Marios-Dimopoulos/stm32-freertos-iot-gateway/docs/architecture.md

# Architecture

This document reflects the **actual current state** of the system, not the
target design. It is updated as subsystems are completed.

**Contents:**
[Current status](#current-status) ·
[Firmware](#firmware-phases-1-and-2) ·
[Architecture decisions](#architecture-decisions-so-far) ·
[System design](#system-design-implemented-this-is-what-runs) ·
[Verification status](#verification-status) ·
[Open questions](#open-questions-not-yet-decided) ·
[Where to continue](#where-to-continue) ·
[Gateway image and Phase 4](#gateway-image-phase-3-built-booted-reachable-over-wi-fi-and-ssh) ·
[Bring-up log (history)](#bring-up-log-history) ·

## Current status

Phases 1 and 2 (firmware) are finished and verified; Phase 3 has a minimal image of my own (`gateway-image`, 39 MB root filesystem, 82 packages) that boots, joins Wi-Fi by itself, can be reached over SSH and reads valid frames from the STM32 over SPI with a test tool; the kernel driver of Phase 4 is finished: my kernel module is an SPI driver that the kernel attaches to the STM32 node through a device-tree overlay (its `probe` runs at boot); a read of `/dev/stm32_sensor_node` does a throw-away transfer and then a second one after a minimum gap of 200 us, checks the marker and CRC and returns the 14 raw bytes of a fresh frame. MQTT is done and runs on the board: the Mosquitto broker listens on the gateway's loopback address only, and my C program `gateway-publisher` reads `/dev/stm32_sensor_node` and publishes one JSON message per frame to `gateway/stm32/bmp280`; init starts it at boot, after the broker. **Not done:** the open items under "Verification status".

FreeRTOS runs on the Nucleo at **84 MHz** (HSI + PLL) with three tasks. The
**sensor task** reads the BMP280 over I2C1 once a second, prints
`T=24.08 C  P=1017.61 hPa` over USART2 (115200 baud, ST-LINK virtual COM port,
Tera Term; a screenshot is in `docs/captures/phase1-terminal-output.png`), and
builds one 14-byte **frame** per period (marker, status, sequence, temperature,
pressure, CRC-16) that it keeps in a one-slot "latest frame" queue. SPI1 is a
**slave**; the master is a Raspberry Pi Zero 2 W. In Phase 2 it ran the stock Raspberry Pi OS
Lite with Python `spidev` as a **temporary test jig** (every Phase 2 number below comes from
it); since Phase 3 it runs my own image `gateway-image`, and since Phase 4 the master side is
my kernel driver (see "Phase 4: the kernel driver"). The **transmit task** (priority 2) is woken by an interrupt on the rising
edge of NSS (the end of a transaction) and loads the newest frame for the next
one; DMA2 stream 3 moves its bytes into the SPI data register, with no CPU
instruction in the transfer. All the reasoning, the failures found on the board
and the numbers are in **ADR-0010**.

**Verified and not verified:** see [Verification status](#verification-status).

**What exists:** the Keil project (`firmware/stm32-sensor-node/`) with the
FreeRTOS kernel and twelve application modules (clock, uart, i2c, bmp280, format,
frame, spi, sensor task, transmit task, hardfault, freertos_callbacks, main), twenty-two ADRs (`docs/decisions/`), the
test script `tools/spi_frame_test.py`, the README, this document, and the logic analyzer
captures of the I2C and SPI links (`docs/captures/`). On the gateway side, `linux-gateway/` has
the Yocto configuration and my layer `meta-gateway` (image recipe `gateway-image`, the kernel
module `stm32-node`, the device-tree overlay, the `spi-frame-test` tool, the Mosquitto broker
configuration, the `gateway-publisher` program and the Wi-Fi, SSH and boot-config changes). The image
boots, joins Wi-Fi, accepts SSH with a key, `/dev/stm32_sensor_node` returns a checked, fresh 14-byte
frame, and `gateway-publisher` publishes it to the local broker at boot.
**What does not exist:** a UART capture, a measured re-arm time, a logic analyzer capture of the kernel
driver.

**Where to continue:** see "Where to continue" below.

## Firmware (Phases 1 and 2)

The Keil project in `firmware/stm32-sensor-node/`: the toolchain, the FreeRTOS kernel and its
configuration, the application modules, the drivers, and the known gaps.

### Toolchain / project setup (done)

- Keil MDK-ARM project: `firmware/stm32-sensor-node/stm32-sensor-node.uvprojx`.
- Compiler: **Arm Compiler 6** (armclang V6.24).
- Single-precision FPU enabled in Target options (required by the
  `ARM_CM4F` port).
- Device support from the Keil STM32F4 DFP: `startup_stm32f411xe.s`,
  `system_stm32f4xx.c` (under `RTE/Device/STM32F411RETx/`).

### FreeRTOS kernel (V11.3.1): source integrated, configuration complete

```
firmware/stm32-sensor-node/FreeRTOS/
  event_groups.c list.c queue.c tasks.c timers.c   → group "FreeRTOS Core"
  include/                                          (vendor headers, unmodified)
  portable/GCC/ARM_CM4F/port.c, portmacro.h        → group "FreeRTOS Portable"
  config/FreeRTOSConfig.h                           → group "FreeRTOS Config"
```

- Include paths: `.\FreeRTOS\include`, `.\FreeRTOS\portable\GCC\ARM_CM4F`,
  `.\FreeRTOS\config`, `.\Src`.
- **Port:** `GCC/ARM_CM4F`, not `RVDS/ARM_CM4F`. The RVDS port uses armcc
  embedded assembler, which Arm Compiler 6 doesn't support. See ADR-0002.
- **No `heap_x.c`** is compiled on purpose, so `pvPortMalloc()` does not exist.
- Vendor files (`include/`, `portable/`, core `.c` files) are kept
  unmodified. Project-specific configuration lives only in `config/`.

### `FreeRTOSConfig.h`: all sections complete

| Section | Status | Settings |
|---|---|---|
| Memory allocation model | done | `configSUPPORT_STATIC_ALLOCATION 1`, `configKERNEL_PROVIDED_STATIC_MEMORY 0`, `configSUPPORT_DYNAMIC_ALLOCATION 0`, `configTOTAL_HEAP_SIZE 0` (ADR-0001) |
| Clock / tick | done | `configCPU_CLOCK_HZ (SystemCoreClock)`, `configTICK_RATE_HZ 1000`, `configUSE_PREEMPTION 1`, `configUSE_TIME_SLICING 1`, 32-bit tick (ADR-0003) |
| Tasks / stacks | done | `configMAX_PRIORITIES 3` (see task table below), `configMINIMAL_STACK_SIZE 128` words, idle/tick hooks off, `configUSE_TIMERS 0`, CLZ task selection, stack overflow check method 2, high-water mark enabled |
| Interrupt priorities (NVIC/BASEPRI) | done | `configMAX_SYSCALL_INTERRUPT_PRIORITY` = level 5 (raw `0x50`), via `configPRIO_BITS 4` + `configLIBRARY_MAX_SYSCALL_INTERRUPT_PRIORITY 5` |
| `configASSERT` | done | disable interrupts (BASEPRI) + infinite loop; enables the port's priority and handler-installation checks |
| Port handler mapping (SVC/PendSV/SysTick → startup file names) | done | direct routing: `#define vPortSVCHandler SVC_Handler` etc. |
| Optional API functions | done | `INCLUDE_vTaskDelay 1`, `INCLUDE_xTaskDelayUntil 1`, `INCLUDE_xTaskGetSchedulerState 1` (the I2C driver asserts with it) and `INCLUDE_uxTaskGetStackHighWaterMark 1` (set in the tasks section); the others stay at the default 0 |

### Application code (`firmware/stm32-sensor-node/Src/`)

- `main.c`: start-up only, in a fixed order: `clock_init_84mhz()`,
  `SystemCoreClockUpdate()`, `uart_init()`, `i2c_init()`, `spi_init()`,
  `sensor_task_create()`, `transmit_task_create()`, `spi_start()`,
  `vTaskStartScheduler()` (ADR-0003). The transmit task must exist before
  `spi_start()`, which enables the interrupt that notifies it. At the scheduler start
  the transmit task (priority 2) runs first and blocks at once, then the sensor task
  runs. The temporary blink task and the LED code are gone (PA5 is SPI1_SCK); they
  are in the git history.
- `sensor_task.c` / `sensor_task.h`: the sensor task, which owns the BMP280 and
  the I2C bus (priority 1, static 256-word stack + TCB, `vTaskDelayUntil` with a
  1 s period). Each period: if the sensor is not initialised it calls
  `bmp280_init()`; otherwise `bmp280_read()` and prints the line. **Any failure**
  is counted, printed as `BMP280 error: <cause> (failures: n)`, and the next
  period initialises the sensor again, so a sensor that was power-cycled
  recovers without resetting the MCU. Every line is built in a 64-byte buffer
  (sized for the worst case) and sent with one `uart_write()`. **Every period, in
  every case**, it also builds one frame (status `NO_READING` after a successful
  init, `OK` with the reading, or the matching failure cause with zeros; a private
  `switch` translates `bmp280_status_t` into `frame_status_t`), numbers it (the
  counter goes up before the build, so the first frame is 1 and 0 is kept for the
  placeholder), and hands it to a one-slot queue (`xLatestFrame`, private to the
  file, `xQueueOverwrite`). The sequence therefore keeps moving while the sensor
  fails: it is a heartbeat. `sensor_task_latest_frame()` copies the newest frame
  out with `xQueuePeek` and never waits. The stack was measured at 89 words peak in
  Phase 1 and again with the frame code at 96 words (160 free), and kept at 256
  (ADR-0005).
- `format.c` / `format.h`: three tiny text functions with no `printf` and no
  `malloc`: `format_text`, `format_u32` and `format_fixed2` (a number in
  hundredths with two decimals: 2364 gives `23.64`, -5 gives `-0.05`). They write
  into the caller's buffer and return the length, or 0 with nothing written if the
  text does not fit. The algorithm was checked in Python on edge cases
  (including the smallest `int32_t`); the C was exercised on the board with real
  values only.
- `freertos_callbacks.c`: `vApplicationGetIdleTaskMemory()` (static Idle TCB +
  stack sized with `configMINIMAL_STACK_SIZE`) and
  `vApplicationStackOverflowHook()` (raise BASEPRI and loop forever).
- `hardfault.c`: the HardFault handler. The start-up file's weak handler is only a
  branch to itself; this one replaces it. A small naked function picks the stack
  that was in use (bit 2 of `EXC_RETURN`: MSP for start-up code and interrupts, PSP
  for a task) and passes its pointer to a C function, which copies the eight
  registers the CPU pushed (R0-R3, R12, LR, **PC**, xPSR), the stack pointer,
  `EXC_RETURN` and the fault status registers (`CFSR`, `HFSR`, `MMFAR`, `BFAR`) into
  a static record, `xFaultRecord`, and stops. The stacked PC is the address of the
  faulting instruction. BusFault, MemManage and UsageFault are not enabled, so they
  all arrive here; the kind is in `CFSR`. It cannot help if the stack pointer itself
  is bad. **Tested on the board** (2026-10-17) with a deliberate read of an unmapped
  address, removed afterwards: the record in the debugger was what the comment at the
  top of the file predicts. How to repeat the test is in that comment.
- `clock.c` / `clock.h`: `clock_init_84mhz()` takes the CPU from the 16 MHz HSI
  to 84 MHz through the PLL (ADR-0006). Five steps in order: flash wait
  states (2) + prefetch + caches, bus prescalers (AHB /1, **APB1 /2 = 42 MHz**,
  APB2 /1), PLL numbers (M 8, N 168, P /4, source HSI), PLL on + bounded wait
  for `PLLRDY`, switch + bounded wait for `SWS`. Returns a status code and
  never hangs; on failure the CPU stays on the HSI. PLL limits are checked
  with `_Static_assert`. `main()` calls it before `SystemCoreClockUpdate()`.
- `uart.c` / `uart.h`: my own register-level USART2 driver (TX only, PA2 =
  AF7). `uart_init()` enables the USART2 and GPIOA clocks, sets PA2 as a
  push-pull, no-pull, low-speed alternate function (stated explicitly even
  where it equals the reset value; AFR written before MODER, MODER last),
  configures 8N1 at 115200 with
  the divisor `BRR = round(PCLK1 / baud)` computed from the real clock
  registers (365 = 0x16D at 42 MHz; it would still be readable on the HSI),
  enables the transmitter, and sets the interrupt priority before enabling it.
  `uart_write()` copies a whole message into a 256-byte static ring buffer
  inside one FreeRTOS critical section and sets `TXEIE`; `USART2_IRQHandler`
  (level 10, i.e. at or below the FreeRTOS line, checked with
  `_Static_assert`) sends one byte per interrupt and clears `TXEIE` when the
  buffer is empty. Only the sensor task calls it today. The critical section
  protects the shared `CR1` register (a benign race, kept anyway) and, for any
  future second caller, task against task and the free-space check with the
  copy as one unit. **All or nothing:** if the message does not fit, nothing is
  stored and `UART_ERR_FULL` is returned, so a line is never cut and tasks'
  messages never interleave. There is no drop counter (removed 2026-10-16: a
  drop cannot happen with one short line per second). Never waits. Tasks
  only, after the scheduler has started (asserted at the start of `uart_write()`,
  like the I2C driver's calls).
  Verified in Tera Term, including the drop behaviour with a temporary burst
  test (removed): two 102-byte lines arrived complete and the third was
  dropped whole.
- `i2c.c` / `i2c.h`: my own register-level I2C1 master driver for the BMP280
  (PB8 = SCL, PB9 = SDA, AF4). `i2c_init()` enables the GPIOB and I2C1 clocks,
  resets I2C1 (`SWRST`), sets the pins as open-drain alternate function with
  the internal pull-up as a backup (MODER written last), programs the 100 kHz
  timing (`CR2.FREQ` = 42, `CCR` = 210, `TRISE` = 43, computed from the real
  APB1 clock) and enables the peripheral. `i2c_write_reg()` and
  `i2c_read_reg()` (1 byte, or 3 or more; 2 is refused because nothing needs
  it) do a whole register transaction and return `I2C_OK`, `I2C_ERR_NACK`,
  `I2C_ERR_TIMEOUT` or `I2C_ERR_BUS`. The waits are bounded in real time by the
  RTOS tick (about 10 ms each), so the driver is task-only; the receive
  deadline operations (clear ACK, ADDR, STOP) run in a short critical section.
  After a timeout, a bus error or a bus that stays busy the driver pulses
  `SWRST` and re-initialises I2C1 itself (counted by `i2c_recovery_count()`,
  which nothing reads); the public functions assert that the scheduler has
  started. **Verified on the board with the BMP280 at 0x76:** register write,
  chip ID 0x58, the 6-byte burst and the 24 trimming bytes; a missing sensor
  gives NACK without hanging; the sensor-disconnect test recovers by itself.
  Grounding SDA gave TIMEOUT on 2026-10-06 and NACK on 2026-10-08 (not
  investigated). **Limits:** no bus clear (a sensor holding SDA low is not
  freed); the pull-ups of the breakout were never measured. **Seen on the wire
  (2026-10-20):** the 3-or-more-byte receive sequence gives ACK on every byte but the
  last and NACK on the last, and SCL runs at a typical 101.1 kHz for the 100 kHz set.
  A sensor locked out by CSB needs a power cycle, which no I2C
  driver can fix (see the BMP280 entry). Decisions (register API, 7-bit
  address, distinct error codes, tick-based bounded polling, critical section
  for the time-critical receive operations, single owner without mutex,
  self-recovery, 100 kHz): ADR-0007.
- `bmp280.c` / `bmp280.h`: the BMP280 module, on top of `i2c_read_reg()` /
  `i2c_write_reg()`; one task owns it (no mutex). `bmp280_init()` does, in
  order: the soft reset (0xB6 to 0xE0), a 10 ms `vTaskDelay`, the chip-ID check
  (0xD0, expected 0x58), a read of the 24 factory trimming bytes into a local
  buffer and, only if it worked, their unpacking (low byte first; `dig_T1` and
  `dig_P1` unsigned, the other ten signed) into a static struct, and then the
  two configuration registers: `config` (0xF5: standby 0.5 ms, IIR filter 16)
  before `ctrl_meas` (0xF4: x16 oversampling for both, normal mode), built from
  named fields (0x10 and 0xB7). Writing `ctrl_meas` starts the measurements.
  The registers are not read back: a wrong value would show in the
  measurements. It must run in a task, after the scheduler has started, and a
  flag set only after a complete init lets `bmp280_read()` assert that init
  succeeded. `bmp280_read()` does one 6-byte burst from 0xF7, assembles the
  two 20-bit raw values (0x80000 means no measurement yet:
  `BMP280_ERR_NO_DATA`) and applies Bosch's integer compensation as two pure
  functions (temperature in 32 bits, pressure in 64 bits; left shifts of
  possibly negative terms are written as multiplications). It returns a
  `bmp280_reading_t`: temperature in hundredths of a degree, pressure in Pa.
  Status codes: `BMP280_OK`, the I2C cause (NACK, TIMEOUT, BUS), `ERR_ID`, and
  `ERR_NO_DATA` (also used if the pressure divisor would be zero);
  `bmp280_status_text()` gives the text. **Verified on the board:** OK with the
  sensor connected; NACK with CSB at GND after a power cycle; the trimming
  bytes in the typical ranges; a reading of 2364 (23.64 C) and 101969 Pa in the
  debugger, now printed every second, stable. With the sensor powered, a
  falling edge on CSB makes it answer NACK until its power is cycled, even
  after CSB goes back to 3.3 V (reproduced twice): CSB must be wired firmly to
  3.3 V. The register layouts and codes were compared with the BMP280 datasheet
  (2026-10-20) and match; the filter code is the one item its text does not list.
  Decisions: ADR-0009.
- `frame.c` / `frame.h`: the contract with the Pi. `frame_build()` writes a 14-byte
  frame byte by byte (little-endian, no struct): marker `0xA5`; status
  (`frame_status_t`: `OK`, `NO_READING`, `SENSOR_NACK`, `SENSOR_TIMEOUT`,
  `SENSOR_BUS`, `SENSOR_ID`, `SENSOR_NO_DATA`, with fixed numbers because they go
  on the wire); sequence (`uint16`); temperature (`int32`, hundredths of a degree);
  pressure (`uint32`, pascals); CRC-16/CCITT-FALSE (polynomial `0x1021`, start
  value `0xFFFF`) over the first 12 bytes, low byte first. A pure function with no
  state. The bytes the C code produces match a Python replica, in the debugger and
  over the wire (test vectors in ADR-0010).
- `spi.c` / `spi.h`: SPI1 as a **slave** (mode 0, 8-bit, MSB first, hardware NSS;
  PA4 NSS with pull-up, PA5 SCK with pull-down, PA6 MISO push-pull, PA7 MOSI; all
  AF5). `spi_init()` enables the clocks, sets the pins and configures SPI1, and
  leaves it **disabled**. `spi_start()` configures DMA2 stream 3 once (channel 3 =
  SPI1_TX, normal mode, memory increment; `PAR` = `SPI1->DR`, `M0AR` = the buffer,
  both base addresses written once), loads a placeholder frame, enables the NSS
  interrupt and only then enables the SPI. `spi_load_frame()`, called by the
  transmit task, stops the stream with a bounded wait, copies the frame into the
  DMA buffer (`ucDmaFrame`, written nowhere else), **writes byte 0 into `DR`
  itself**, sets `NDTR` for the remaining 13 bytes and enables the stream: the
  state after it is the same whatever the previous transaction was. The EXTI line 4
  handler (NVIC level 6) clears the pending bit and reads PA4: high means a real
  end of a transaction (counted in `ulNssRisingCount`, the transmit task is woken),
  low means a spike (counted in `ulNssGlitchCount`, nothing else). Counters for the
  debugger: `ulNssRisingCount`, `ulNssGlitchCount`, `ulReloadFailures`. Decisions
  and failures: ADR-0010.
- `transmit_task.c` / `transmit_task.h`: priority 2, static 128-word stack (measured:
  39 words peak, ADR-0005). It waits without limit for a task notification (`ulTaskNotifyTake( pdTRUE,
  portMAX_DELAY )`: the count is cleared, so ends that merge cost one wake-up), then
  fetches the newest frame with `sensor_task_latest_frame()` (the placeholder if the
  queue is still empty) and calls `spi_load_frame()`. `ulWakeUps` counts its
  wake-ups. The NSS handler gives it the notification through
  `transmit_task_end_of_transaction_from_isr()`; the handle stays private.
- Footprint, from the Keil build of 2026-10-17 10:52
  (`Listings/stm32-sensor-node.map`): Code 18,316 B, RO data 612 B (18,928 B = 18.5 KB
  of flash in total), RAM 4,072 B of 128 KB (RW 8 B + ZI 4,064 B, including the 1 KB
  main stack, the stacks of the sensor task (1 KB) and the transmit task (512 B), the
  UART buffer, and the 56-byte fault record). The start-up heap is 0 bytes since
  2026-10-17: the 512-byte C-library heap that nothing used is gone (RAM was 4,536 B
  in the map of 2026-10-15, before it and before the record were added). The growth
  since Phase 1 (12.8 KB of flash, 3.8 KB of RAM) is the frame, SPI, DMA, EXTI,
  transmit-task and fault-handler code, plus the queue code of the kernel. **No
  `malloc` is linked** (the only matches in the map are the library function
  `_get_argv_nomalloc`). The 64-bit division comes from the C library
  (`__aeabi_ldivmod`). Keil's static stack report gave 324 B for the start-up call
  chain on the main stack in an earlier build (interrupts not included).

### Drivers

The course/teacher drivers (ARM University Program, ST Standard Peripheral
Library, teacher-written I2C) are kept **locally only** in
`firmware/**/reference/` (git-ignored, outside the Keil project) as reading
material. The clock, USART2, I2C1 and SPI1/DMA drivers were written from scratch at
register level, and the BMP280 module is built on them (the compensation
formulas are Bosch's, as in the `functions.c`). The decision to write own
register-level drivers instead of using a vendor library is ADR-0008.

### Known gaps (real current state, not bugs)

- **What the logic analyzer showed on 2026-10-20, and what is still open** (the re-arm time,
  the UART bit time): see "Verification status" (ADR-0006, ADR-0007, ADR-0010).
- **Spikes on NSS** (ADR-0010, decision 8): the counts, what the handler does and the open cause
  are in "Verification status".
- **The first read after an idle time is stale.** The buffer is refilled right
  after each transaction and nothing refreshes it, so a Pi that has not read for a
  minute gets a frame about a minute old (the sequence number shows it). The node is
  unchanged; the Phase 4 driver reads twice and keeps the second frame (ADR-0019), so
  programs that use `/dev/stm32_sensor_node` get a fresh one. A node that has just
  started can still return the placeholder (`status=1`) for its first second.
- The Phase 2 numbers come from the stock Raspberry Pi OS with Python `spidev`, a
  temporary jig (ADR-0010). The final master is `gateway-image` with the kernel driver.
- The SPI `OVR` flag (received bytes are never read) is set and not cleared;
  nothing has gone wrong that it would explain (30000 back-to-back reads were good).
- **Stacks.** Measured on 2026-10-18 after 60 reads from the Pi, as lower bounds:
  sensor task 96 words peak of 256, transmit task 39 words of 128 (the placeholder
  path did not run, and the NACK paths were not exercised). Idle: at least 21 words
  actually written (the `0xA5` pattern said 14, but R4-R11 were saved with the fill
  value, so the pattern was forged by data), 128 words allocated (ADR-0005).
- **Clock accuracy is that of the HSI: measured about 1.1% fast (ADR-0006).** The
  timeout/error paths of
  `clock_init_84mhz()` have never been triggered. `SystemCoreClock` reports HCLK
  only: USART2 and I2C1 must use the 42 MHz APB1 clock.
- `vApplicationGetTimerTaskMemory()` is NOT needed (`configUSE_TIMERS 0`).
- The I2C driver has no bus clear (a sensor holding SDA low is not freed), and
  nothing reads `i2c_recovery_count()`.
- The BMP280 can be locked out of I2C by a glitch on CSB until its power is
  cycled; the sensor task reports it and keeps trying, but only a power cycle
  fixes it.
- `docs/captures/` holds the Phase 1 screenshot and the logic analyzer captures (its
  README lists them). `docs/budget.md` is not updated with the real purchases.
- There is no LICENSE file (a decision, not an oversight).

## Architecture decisions so far

- ADR-0001: static-only memory allocation for FreeRTOS objects.
- ADR-0002: GCC/ARM_CM4F FreeRTOS port with Arm Compiler 6.
- ADR-0003: RTOS tick derived from `SystemCoreClock`, at 1 kHz.
- ADR-0004: interrupt priority threshold for FreeRTOS API calls at level 5.
- ADR-0005: task stacks sized by measurement with a margin; Idle stays at 128
  words; the sensor task (96 words peak) and the transmit task (39 words peak) were
  measured and keep 256 and 128.
- ADR-0006: CPU at 84 MHz from the HSI through the PLL, in its own module.
- ADR-0007: I2C1 driver: register-oriented polling API with tick-based timeouts and
  self-recovery.
- ADR-0008: own register-level drivers instead of a vendor library (decided
  2026-10-02, recorded 2026-10-08).
- ADR-0009: BMP280 module: normal mode, integer results, initialise again after
  every error.
- ADR-0010: the SPI link: the Pi as master and the STM32 as slave, a fixed 14-byte
  frame with CRC-16, a one-slot latest-frame queue, a transmit task that re-arms a
  normal-mode DMA on the NSS rising edge; the CPU primes the data register
  (decision 7); NSS spikes are ignored (decision 8).
- ADR-0011: the gateway image is built with Yocto (not Buildroot): the industry standard,
  and its layers keep my driver and recipes separate from the Raspberry Pi support.
  Phase 3 has started.
- ADR-0012: Yocto Wrynose 6.0 (LTS); BitBake 2.18, openembedded-core, meta-yocto and
  meta-raspberrypi cloned by hand into `~/yocto/` in WSL, outside the repo.
- ADR-0013: the `synaptics-killswitch` license flag is accepted so that the Pi Zero 2 W's
  Wi-Fi firmware is built into the image (the gateway needs Wi-Fi).
- ADR-0014: the `buildpaths` quality check is switched off for the `perl` recipe only
  (a workaround; the cause is not found; perl is not in the image).
- ADR-0015: the Wi-Fi network is typed on the board for now (the password stays out of the
  repo and the build) and OpenSSH is the SSH server; it also records the first OpenSSH build
  that shipped seven 0-byte programs.
- ADR-0016: a layer of my own, `meta-gateway`, with a `.bbappend` that replaces
  `/etc/network/interfaces` (`auto wlan0`, `nl80211`), so Wi-Fi starts at boot.
- ADR-0017: an image recipe of my own, `gateway-image`, built up from `packagegroup-core-boot`
  one tested step at a time (142 MB and 2015 packages down to 37 MB and 76).
- ADR-0018: a kernel SPI driver (not `spidev`) with a character device that returns the raw 14-byte
  frame; the driver checks the marker and CRC, the reading program decodes the values; `probe` does
  not fail when the node does not answer.
- ADR-0019: the stale first read is handled in the driver: every `read()` does a throw-away transfer
  first and returns the second frame (no firmware change; about 0.4 ms more per read).
- ADR-0020: the MQTT broker (Mosquitto) runs on the Pi and the publisher is a C program with
  libmosquitto; both come from `meta-openembedded`, a fifth repository. Built and running.
- ADR-0021: one JSON message per frame on the topic `gateway/stm32/bmp280`; the publisher reads every
  0.2 s and publishes when `seq` changes; a frame with `status` other than 0 is published without
  numbers, and `-EIO` is only logged; the broker listens on localhost only, reached through an SSH tunnel.
- ADR-0022: the publisher is started at boot by an init script (`S40`, after the broker's `S30`), waits
  by itself for the device file and the broker, and logs to syslog (`/var/log/messages`).

## System design (implemented: this is what runs)

```
 BMP280 ──I2C1 (PB8 SCL, PB9 SDA)──┐
                                    ▼
        ┌─────────────────────────────────────────────────────────────┐
        │ STM32F411RE (Nucleo, 84 MHz), FreeRTOS, static allocation   │
        │                                                             │
        │  Sensor task (prio 1, 1 s) ──frame──► latest-frame queue    │
        │       │                                    │ xQueuePeek     │
        │       └─ lines ─► USART2 (PA2) ─► ST-LINK  │                │
        │                   virtual COM, Tera Term   ▼                │
        │  Transmit task (prio 2) ◄─ notify ◄─ EXTI4 ISR (NSS rising) │
        │       │ spi_load_frame()                                    │
        │       ▼                                                     │
        │  ucDmaFrame ──DMA2 stream 3──► SPI1->DR  (SPI1 slave)       │
        └───────────────────────────────────────────┬─────────────────┘
                              PA4 NSS, PA5 SCK, PA6 MISO, PA7 MOSI │
                                                                    ▼
                                       Raspberry Pi Zero 2 W (SPI master)
```

The gateway side (Phase 3 and 4, implemented up to the MQTT broker):

```
 STM32 node ──SPI0, chip select 0, 1 MHz──► spi-bcm2835 (controller driver)
                                                   │
                  SPI core (spi.c): spi_sync_transfer, queue
                                                   │
        stm32_node.ko (my spi_driver, bound by the overlay's compatible)
          read(): transfer, wait 200 us, transfer, check marker + CRC
                                                   │
                           /dev/stm32_sensor_node  (14 raw bytes per read)
                                                   │
                  gateway-publisher (C, libmosquitto): read every 200 ms,
                  publish JSON when seq changes
                                                   │ localhost:1883 (loopback only)
                  Mosquitto broker ── topic gateway/stm32/bmp280
                                                   │ SSH tunnel (tested 2026-11-01)
                  subscribers: mosquitto_sub on the Pi; my laptop
```

- One task reads the BMP280 over I2C1 (PB8/PB9) once a second and builds a frame.
- **Sensor: Bosch BMP280** (temperature + pressure; no humidity, unlike the
  BME280). Chip ID register `0xD0` reads `0x58`. I2C address `0x76` or
  `0x77` depending on the SDO pin.
- **Debug logging:** the sensor task prints readings directly over USART2
  (PA2 = TX; PA3 = RX is not used), which the Nucleo's ST-LINK exposes as a
  virtual COM port, by interrupt through a ring buffer, whole messages or
  nothing. This is a debug-only aid, not part of the data path (that is SPI +
  DMA). No dedicated logging task.
- No MPU-6050 IMU: it was dropped from the design.
- All RTOS objects (the tasks, the latest-frame queue) are statically allocated.

### The frame (the contract with the Pi, `frame.h`, ADR-0010)

| Bytes | Field |
|---|---|
| 0 | marker `0xA5` |
| 1 | status (`frame_status_t`: 0 OK, 1 no reading yet, 2 to 6 the sensor failure causes) |
| 2-3 | sequence (`uint16`, +1 per frame built, the first is 1; 0 is the placeholder) |
| 4-7 | temperature (`int32`, hundredths of a degree Celsius) |
| 8-11 | pressure (`uint32`, pascals) |
| 12-13 | CRC-16/CCITT-FALSE over bytes 0 to 11, low byte first |

All multi-byte fields are little-endian. The Pi decides when to read (it polls); the
node always keeps the newest frame loaded. A dead node reads as `0xFF` or `0x00`,
never `0xA5`; a repeated sequence means "nothing new"; a jump means frames were
skipped; a wrong CRC means damage.

### Task set and priorities (implemented)

Task priority: higher number = more urgent. `configMAX_PRIORITIES = 3`.

| Priority | Task | Why this level |
|---|---|---|
| 2 | Transmit task (re-arms the SPI DMA after every transaction) | The Pi is the SPI master and clocks data out when it decides, so the deadline is imposed from outside; when the interrupt wakes it, it must run at once, even in the middle of an I2C transfer of the sensor task. |
| 1 | Sensor task (BMP280 over I2C1, frames, debug prints) | Period chosen by me; a few ms of lateness is harmless. |
| 0 | Idle | Runs when nothing else is ready. |

At start-up the transmit task runs first (it is the highest priority), blocks at once,
and the sensor task runs next.

### Interrupt levels (lower number = more urgent)

ISRs that call `...FromISR()` functions must be at level 5 or a larger number
(ADR-0004).

| Level | Interrupt | Note |
|---|---|---|
| 6 | EXTI line 4 (NSS rising edge) | calls `vTaskNotifyGiveFromISR`; more urgent than the UART because the re-arm must finish before the next chip select |
| 10 | USART2 (transmit) | calls no FreeRTOS function |
| 15 | PendSV, SysTick | set by the kernel port |

No DMA interrupt is used: the stream stops by itself after its count, and the end of a
transaction is detected on the NSS pin (ADR-0010, decision 6).

## Verification status

What was measured on the board, what was not, and what is still undecided, in one place. The tests of
Phases 3 and 4 are under their own steps in the Gateway image section (Wi-Fi and SSH, SPI and the
test tool, steps 4.2 to 4.6c, "Checks on the board").

### Verified on the board (Phases 1 and 2)

- Phase 1: register values and SysTick `LOAD = 83999` checked in the debugger;
  disconnecting the BMP280 gives `NACK` and everything comes back by itself; a
  falling edge on its CSB pin locks it out of I2C until its power is cycled
  (ADR-0007).
- The Pi reads a real frame every second with a valid CRC, at SPI clocks from
  100 kHz to 6 MHz, and back to back from Python (no pause between reads).
- 3000 reads in about 35 s with the node running freely: every interrupt and
  wake-up counted, no I2C error on the sensor task (the transmit task preempts it).
- A short or interrupted transaction does not leave the node shifted by one byte:
  at every re-arm the CPU writes byte 0 into the SPI data register itself
  (ADR-0010, decision 7).
- A 30-minute run (1800 reads, 1 s apart): 1797 good, 0 shifted, 3 bad. The node's
  counters agreed with the Pi (1800 ends, 1800 wake-ups, 0 reload failures), and 15
  spikes on NSS were ignored. One of the bad frames is a 2-bit slip, probably noise
  on SCK (ADR-0010).
- Ten runs of the test script stopped with Ctrl+C, and a run after them: no shifted
  or bad frame (ADR-0010).
- Noise on NSS: spikes on that line are ignored by the interrupt handler
  (decision 8). With the wires still, 7 spikes were seen in 3000 transactions and
  none damaged a frame; moving the wires by hand corrupts frames, which the Pi
  detects with the CRC, and the next frame is good.
- The sensor failing travels in the frame: with SDA unplugged the Pi gets frames
  with status `NACK` and zeros, then `NO_READING`, then `OK` when it is back.
- On the wire, with a logic analyzer (2026-10-20, `docs/captures/`): every BMP280 read
  is START, `0xEC`, `0xF7`, repeated START, `0xED`, six bytes (ACK on the first five,
  NACK on the last), STOP, 834 us (ADR-0007); the SPI frame is 112 clocks in mode 0 and
  decodes with a valid CRC; SCK measured 1.000, 2.000, 3.997 and 5.88 MHz for 1, 2, 4
  and 6 MHz requested; NSS stays high 154 to 228 us between back-to-back reads, and
  30000 such reads were good (ADR-0010). The CPU clock runs about 1.1% fast (ADR-0006).
- More from the same captures (logic analyzer: a Raspberry Pi Pico with sigrok-pico): the
  clock error above makes the "1 s" sensor period 0.988 to 0.989 s; for 1 MHz requested
  SCK was once 0.625 MHz (ADR-0010); the Pi adds one extra clock period between bytes; the 30 gaps
  between back-to-back Python reads were 154 to 228 us, and 30000 such reads were all good.

### Not verified

- **The re-arm time of the node** is not measured, only an upper bound: the node was ready within
  the 154 us minimum gap of back-to-back reads (the measurements are listed above). Measuring it
  would need a marker pin in the firmware. A kernel driver or a C program may be
  much faster than Python, so the Phase 4 driver enforces a 200 us delay (step 4.5b, not yet seen on
  the wire); whether 200 us is a real margin needs a logic analyzer capture of NSS with the kernel
  driver.
- **The UART bit time** is not measured: PA2 is wired to the ST-LINK only. With the solder bridges at
  their default, SB62 and SB63 open, the `D1` socket and the morpho pin do not carry it, per the
  Nucleo-64 manual UM1724 (PA2 is not reachable on the headers). I did not change the bridges, so the
  board was not modified.
- **The cause of the NSS spikes** that the firmware counts is not settled. They are 0.2% to 0.8% of
  the transactions with the wires still (the counts are listed above), many when the wires are moved;
  the interrupt handler ignores them (ADR-0010, decision 8). The logic
  analyzer saw spikes of 50 ns on NSS exactly at SCK's falling edge with a probe wiring that disturbed
  the link (spikes only with such a wiring), and none in about 40 frames with a clean wiring; long
  jumpers are the suspect. Frames hit by a real loss of contact are corrupted, and the CRC finds them;
  the next one is good.
- **MOSI on the wire** is not verified (`docs/captures/README.md` says why it was not probed).
- **The stale first read after an idle time** still exists in the node; the Phase 4 driver hides it
  (ADR-0019; the mechanism is under "Known gaps").
- I did not compare the SSH host key fingerprint on the board with the one the client
  showed, and I did not log in with the name `raspberrypi0-2w-64.local` (the error type
  suggests it resolved).
- The cause of the 0-byte OpenSSH programs is a hypothesis; I also cannot explain why
  `test -x /usr/sbin/sshd` was false on the board for an empty file with the executable bit.
  After every build I should look for zero-byte files in the root filesystem folder.
- The root filesystem on the board is writable, and `/boot` (FAT) is mounted read-write with
  `defaults`: a power cut during a write there could corrupt it. For the final image it should
  be read-only or not mounted (decided on 2026-10-27 not to do it in this project).
- The Wi-Fi key and the root password hash are inside every image and in the build folder.
  Anyone with the SD card can read them. SSH is key-only since 2026-10-27; the
  private key is on my PC without a passphrase, so whoever copies that file can log in.
- Phase 4 driver, not verified: the 200 us gap and the 1 MHz clock on the wire (no logic analyzer
  capture of the driver; the exact clock the divider gives), 500 sequential reads with the 4.5c
  build, and why the first module build recompiled the whole kernel.
- Only the driver's `-EIO` path (node off) and `-EINVAL` (`bs=4`) were seen; `-EFAULT` and
  `-ENODEV` were not triggered. The driver does not say whether the marker or the CRC failed.
- Wi-Fi power save: the commit `254c5d3` adds a line to `interfaces` that turns power save off after
  `ifup`, because I suspected it of unanswered ARP and dropped SSH. It is in the image since the
  build of 2026-10-31, and `iw dev wlan0 get power_save` says `Power save: off` on the board; at boot
  `dmesg` shows `power save disabled` (2026-11-01). That shows the setting is applied. It does not show
  that the original problem is gone; that needs time on the network, and I have not watched for it.
- The `spi-frame-test` runs (two, 10 frames each) were on the old image with `/dev/spidev0.0`; no speed
  sweep, no minimum-gap test, nothing on the logic analyzer from the gateway image.
- `perl` is built although it is not in the image; why is not known (ADR-0014).
- `core-image-base` carried things a headless sensor gateway does not need (the services
  `alsa-state`, `avahi-daemon`, `bluetooth`, `ofono`, `neard`); `gateway-image` does not. The
  boot partition still has an audio line in `config.txt` (`dtparam=audio=on`). The graphics
  overlay and the 256 MiB CMA pool are gone since 2026-10-27. Switching the
  graphics off with `DISABLE_VC4GRAPHICS = "1"` failed the build in `cairo` (the `meta-raspberrypi`
  `cairo_%.bbappend` adds an `egl` option that `cairo` 1.18.4 does not have), so I left it as it
  is (ADR-0017 update of 2026-10-25).
- `bblayers.conf` uses `${TOPDIR}/../` paths
  since 2026-11-01 (checked with `bitbake-layers show-layers` and `bitbake -p`), so it needs `build/`
  and the layers in the same parent folder. BitBake reads `~/yocto/meta-gateway`, not the copy in
  git; the two are kept the same by hand. Three files changed in git on 2026-11-02 and 2026-11-03:
  `gateway-image.bb` (the root password file is now found at `${TOPDIR}/../secrets/root.hash`),
  `stm32_node.c` (one comment) and the Wi-Fi `.bbappend` (the secrets folder is now
  `${TOPDIR}/../secrets` instead of an absolute path with my user name). On 2026-11-03 I copied all
  three to `~/yocto/meta-gateway` and built the image (`...rootfs-20261103174036.wic.bz2`). In the
  root filesystem folder the root field of `/etc/shadow` is the same as `root.hash`, and
  `/etc/wpa_supplicant.conf` is the same as my secrets file (not the placeholder). Both checks printed
  only SAME or DIFFERENT, never the values. I flashed this image the same day: the Pi joined Wi-Fi at
  boot with only power connected, SSH with the key worked, root logged in with the password on the
  serial console, and `mosquitto_sub` showed the messages again.
- **The shutdown order** on the board is not verified: the `rc6.d` links put `K20gateway-publisher`
  before `K20syslog` and `K30mosquitto` (see "How the driver is found and loaded" in the Phase 4
  section); a shutdown was not watched.
- **A frame with a bad CRC produced on purpose** was not seen: my test of shaking the wires, 1000
  reads with no failure, was too weak to show anything.

### Open questions (not yet decided)

- Whether the publisher needs to be restarted by init if it crashes (ADR-0022: nothing does it now).
- Whether the HSI accuracy stays good enough, or the clock moves to the ST-LINK's
  8 MHz HSE (needs `HSE_VALUE=8000000`, see ADR-0006). Measured: about 1.1% fast
  (ADR-0006), which nothing in the project needs better than so far; to be decided
  again if a precise timestamp or USB is ever needed, and checked against the UART
  bit time.
- Whether a bus clear is ever needed in the I2C driver (only if a sensor is
  seen holding SDA low).
- The spikes on NSS, the re-arm time and the 200 us gap are not decisions but missing
  measurements: see "Not verified" above.

## Where to continue

### Phases 1 and 2: finished

Phase 2 is closed. What was done: the long run and the aborted runs with
`tools/spi_frame_test.py` (ADR-0010), the stack measurements (ADR-0005), and the logic
analyzer captures of I2C and SPI (2026-10-20, `docs/captures/`). Open items that are accepted and not blocking: the re-arm time, the UART bit time, whether the
firmware's own NSS spikes are real, and the stale first read after an idle time (the Phase 4
driver handles it, ADR-0019). Details: "Verification status".

### Phases 3 and 4

Phase 3: the image is built, flashed and boots on the board to a root login on the serial
console (see "First boot" in the Bring-up log). Wi-Fi starts at boot (ADR-0016) and the network is in the
image (key kept outside the repo, ADR-0015), so SSH works after a flash with nothing typed.
SPI is on and the test tool `spi-frame-test` read valid frames from the STM32 (see "SPI and
the test tool"). The image is my own minimal recipe (ADR-0017). Root has a password (hash kept
outside the repo, ADR-0015 update of 2026-10-24) that only the serial console asks for: since
2026-10-27 SSH accepts a key only. The clean-up of the image is done as far as I decided
(ADR-0017 updates of 2026-10-25 and 2026-10-27).

Phase 4: the kernel driver is finished (see "Phase 4: the kernel driver"). The two requirements
that came from Phase 2 are met: a minimum delay between SPI transfers (step 4.5b) and a policy
for the stale first read (read twice, step 4.5c, ADR-0019). Step 4.6 (MQTT) is done since 2026-11-01 and step 4.7 (docs) since 2026-11-02.

## Gateway image (Phase 3: built, booted, reachable over Wi-Fi and SSH)

The image is built with Yocto Wrynose 6.0 (ADR-0011, ADR-0012) in WSL2 (Ubuntu 24.04,
12 GB of RAM given to WSL through `.wslconfig`). The repos are cloned by hand into
`~/yocto/`, outside this repo. Cloned on 2026-10-18:

| Repo | Branch | Commit | Date of the commit |
|---|---|---|---|
| `bitbake` | `2.18` | `6e260eb6ab16` | 2026-10-07 |
| `openembedded-core` | `wrynose` | `636e5d3b12d5` | 2026-10-12 |
| `meta-yocto` | `wrynose` | `7c25b1115655` | 2026-09-30 |
| `meta-raspberrypi` | `wrynose` | `919588393f41` | 2026-10-10 |
| `meta-openembedded` (added 2026-10-31, ADR-0020) | `wrynose` | `c734c2cb9713` | 2026-10-29 |

### Build configuration

The configuration is used from `~/yocto/build/conf/` in WSL. Copies are in
`linux-gateway/conf/`: `bblayers.conf` byte for byte, and `local.conf` trimmed to its
active lines with my comments (the 20 active lines were compared with the real file on
2026-10-25 and are identical; the `local.conf` check was not repeated on 2026-10-31).
`bblayers.conf` lists seven layers: `openembedded-core/meta`, `meta-yocto/meta-poky`,
`meta-raspberrypi`, `meta-gateway` (mine, ADR-0016; it is in `~/yocto/` and a copy is in
`linux-gateway/meta-gateway/`) and, since 2026-10-31, `meta-oe`, `meta-python` and `meta-networking`
from the one repo `meta-openembedded`. Mosquitto is in `meta-networking`, which depends on the other
two; `meta-python` makes recipes available but puts no Python in the image. Added with
`bitbake-layers add-layer`, which checked the dependencies; the repo copy was compared with the real
file (identical). `local.conf` adds, on top of the template:

```
MACHINE = "raspberrypi0-2w-64"
DISTRO = "poky"
ENABLE_UART = "1"
LICENSE_FLAGS_ACCEPTED = "synaptics-killswitch"       (ADR-0013)
INSANE_SKIP:perl += "buildpaths"                      (ADR-0014)
ENABLE_SPI_BUS = "1"                                  (added 2026-10-23: `dtparam=spi=on` in config.txt)
USE_VT = "0"                                          (added 2026-10-25: no getty on tty1)
```

The package list and the `IMAGE_FEATURES` (`ssh-server-openssh`; `allow-root-login` was removed on
2026-10-27) of the current image are not in `local.conf` but in my image recipe
`meta-gateway/recipes-core/images/gateway-image.bb` (ADR-0017), together with the functions that
write the root password hash and install the SSH public key. Until 2026-10-24 the `IMAGE_FEATURES`, including the two that
allowed an empty root password, were in `local.conf` and applied to every image.

### The image recipe `gateway-image` (2026-10-24, ADR-0017)

`meta-gateway/recipes-core/images/gateway-image.bb` inherits `core-image` for the image tasks, but
replaces its package list: `IMAGE_INSTALL = "packagegroup-core-boot"` plus Wi-Fi (`wpa-supplicant`,
`iw`, `wireless-regdb-static`, the firmware packages `...bcm43430` and `...bcm43436`, the modules
`brcmfmac`, `brcmfmac-cyw`, `brcmutil`, `cfg80211`), SPI (`spi-bcm2835`, `spidev`) and
`spi-frame-test`, and (since 2026-10-25) my kernel module `stm32-node`. Since the overlay of step 4.3,
`spidev@0` is disabled, so `spidev` and `spi-frame-test` are still in the image but cannot be used on
chip select 0 (`/dev/spidev0.0` is gone); they could be dropped from the list. The recipe also
installs the SSH key, puts the overlay on the boot partition (`IMAGE_BOOT_FILES`) and keeps the
root password hash. `BAD_RECOMMENDATIONS +=
"kernel-image-*"` keeps the 26 MB kernel copy out of the
root partition (the kernel is loaded from partition 1), and `IMAGE_LINGUAS = ""` drops the
language files. The comments in the recipe say why each name is there.

| Image | Root fs | Packages | Compressed |
|---|---|---|---|
| `core-image-base` | 142 MB | 2015 | 78 MiB |
| `gateway-image`, minimal (step 1) | 29 MB | 47 | 32 MB |
| `gateway-image`, final of 2026-10-24 | 37 MB | 76 | 35 MB |

On the board (state of 2026-10-24, before the overlay): boots from the kernel on partition 1, `wlan0` up
with an address from the router, `/dev/spidev0.0`, `spi-frame-test 10` gave 10 of 10 valid frames. The `getty` on `tty1` was removed
on 2026-10-25 (`USE_VT = "0"`); one `getty` runs, on `ttyS0`. Still in it: `kbd` and `keymaps` (1.7
MB, hard dependency of `packagegroup-core-boot`, left on purpose), the three `ip: SIOCGIFFLAGS`
lines at boot, and the Wi-Fi key and the root password hash (both in every image). Not measured:
boot time, memory use.

### Wi-Fi at boot: the layer `meta-gateway` (2026-10-23, ADR-0016)

The recipe `init-ifupdown` (openembedded-core) installs `/etc/network/interfaces` from a file
next to the recipe. My layer has `recipes-core/init-ifupdown/init-ifupdown_%.bbappend` with
`FILESEXTRAPATHS:prepend := "${THISDIR}/${PN}:"` and, in `init-ifupdown/`, my copy of
`interfaces`: the original plus `auto wlan0`, and `wpa-driver nl80211` instead of `wext`.

- `bitbake-layers show-appends` listed the `.bbappend` under `init-ifupdown_1.0.bb`; the root
  filesystem folder of the new image had both changes.
- On the board (after a flash, `passwd` and a hand-written `/etc/wpa_supplicant.conf`): after a
  reboot, with no `ifup wlan0`, SSH from Windows worked. `/proc/<pid>/cmdline` of
  `wpa_supplicant` ended with `-D nl80211`, and `dmesg` had no line about wireless extensions.
- Not checked: whether the `SIOCSIWENCODEEXT` errors are gone from the output of `wpa_supplicant`.

### Wi-Fi network in the image (2026-10-23, ADR-0015 update)

The recipe `wpa-supplicant` installs `/etc/wpa_supplicant.conf` (mode 600) from a file named
`wpa_supplicant.conf-sane`. My layer has `recipes-connectivity/wpa-supplicant/wpa-supplicant_%.bbappend`
with `FILESEXTRAPATHS:prepend := "/home/mariosdimopoulos/yocto/secrets:"` (since 2026-11-03
`"${TOPDIR}/../secrets:"`, the same folder without my user name; built, flashed and the Pi
joined Wi-Fi on 2026-11-03). The folder
`~/yocto/secrets/` is outside the repo and holds my `wpa_supplicant.conf-sane` (country, SSID and
the derived `psk`; `.gitignore` has a rule for any `secrets/` folder). With the image flashed, the
Pi joined Wi-Fi at boot and SSH worked with nothing typed on the board. If the folder is missing
the build does not fail and the placeholder network is installed.

### Phase 4: the kernel driver

**Plan** (agreed 2026-10-25): 4.1 design decisions (ADR-0018); 4.2 an empty kernel
module in a recipe; 4.3 the SPI driver with `probe`/`remove` and the device-tree overlay; 4.4 one
SPI transfer, marker and CRC check; 4.5 the character device `/dev/stm32_sensor_node`, the minimum
gap and the policy for the stale first read; 4.6 MQTT; 4.7 docs. **Status (2026-11-02): all steps
done. 4.1 to 4.5c (the driver); 4.6a, 4.6b and 4.6c (layers, broker in the image, the publisher
started at boot); 4.7 (README, `linux-gateway/README.md`, this document).**
MQTT was paused from 2026-10-29 until the driver was understood, and restarted on 2026-10-31.

**Facts found while planning:**
- No Mosquitto recipe exists in `openembedded-core`, `meta-yocto` or `meta-raspberrypi`: it is in
  `meta-openembedded` (a fifth repository), so MQTT needs its own decision.
- The Pi's base device tree has two `spidev` nodes under `spi@7e204000` (`spidev@0`, `spidev@1`,
  `compatible = "spidev"`). The STM32 is wired to chip select 0, which `spidev@0` occupies, so the
  overlay must disable that node and add ours at `reg = <0>`. The labels `spi0`, `spidev0` and
  `spidev1` exist in the running tree (`/proc/device-tree/__symbols__`). `/boot/overlays` holds 77
  files, none with `spi` in its name: they are the fixed list `RPI_KERNEL_DEVICETREE_OVERLAYS` of
  `rpi-base.inc`, built from the kernel's own source, so there is no ready-made SPI overlay.
- The interface to user space is a character device with the raw 14-byte frame (option B of
  ADR-0018); text output and an IIO device were the alternatives. Decided and recorded in
  ADR-0018 (2026-10-29).

**Step 4.2 (2026-10-25): the empty module.** `meta-gateway/recipes-kernel/stm32-node/` has the recipe
(`inherit module`, GPL-2.0-only), a `Makefile` with `obj-m := stm32_node.o`, and `stm32_node.c` with
`module_init`/`module_exit` that print `loaded` and `unloaded`.
- The first `bitbake stm32-node` compiled the **whole kernel** (`linux-raspberrypi do_compile`, over 14
  minutes; 42 of 1028 tasks ran), because a module is built against the kernel's build tree and that
  tree was not in the work folder. Why the cache did not cover it, I do not know.
- The module is installed as `/lib/modules/6.18.33-v8/updates/stm32_node.ko.xz` (compressed like the
  other modules; the folder is `updates`, not `extra` as I first wrote in a comment) in the package
  `kernel-module-stm32-node-6.18.33-v8`.
- Putting `kernel-module-stm32-node` on the image list failed in `do_rootfs` (`No match for argument`,
  `neither a recipe nor a generated package`), although the package data lists it as an alias. The
  recipe name `stm32-node` on the list works: the `module` class makes that package empty and
  dependent on the real one. I do not know why the alias fails for my module and works for `spidev`.
- On the board (`gateway-image-...rootfs-20261025162512.wic.bz2`): `modprobe stm32_node` printed
  `stm32_node: loading out-of-tree module taints kernel.` and `stm32_node: loaded`; `lsmod` showed 12288
  bytes; `rmmod` printed `stm32_node: unloaded`. The taint line is the normal flag for a module that is
  not in the kernel tree.

**Step 4.3 (2026-10-25): the module becomes an SPI driver, and an overlay attaches it.**
- `stm32_node.c` uses `module_spi_driver()` to register an `spi_driver` with an `of_match_table`
  (`mdimopoulos,stm32-sensor-node`), an `spi_device_id` table (`stm32-sensor-node`), a `probe` and a
  `remove` that only print a line with `dev_info()`. No SPI transfer yet.
- New recipe `recipes-bsp/stm32-node-overlay/` (`inherit devicetree`) compiles `stm32-node.dts`, an
  overlay (it has the line `/plugin/;`) with two fragments: `spidev0` gets `status = "disabled"`, and a
  node `stm32@0` is added under `spi0` with the `compatible` above, `reg = <0>` and
  `spi-max-frequency = <1000000>`. In the recipe: `COMPATIBLE_MACHINE` (the class refuses every machine
  by default), `PROVIDES:remove = "virtual/dtb"` (an overlay is not the base tree) and
  `KERNEL_INCLUDE = ""` (no dependency on the kernel configure step; the overlay includes nothing). The
  class deploys `devicetree/stm32-node.dtbo` into `deploy/images/raspberrypi0-2w-64/`.
- How it reaches the board: the kernel's overlays cannot include mine (fixed list, kernel source). So
  `gateway-image.bb` has `IMAGE_BOOT_FILES:append = " devicetree/stm32-node.dtbo;overlays/stm32-node.dtbo"`
  and `do_image_wic[depends] += "stm32-node-overlay:do_deploy"`, and `rpi-config_%.bbappend` sets
  `RPI_EXTRA_CONFIG:append` so that `config.txt` gets the line `dtoverlay=stm32-node`. The `\n` in that
  value became a real new line (checked in `deploy/.../bootfiles/config.txt`).
- Builds: `bitbake stm32-node-overlay` alone, 853 tasks, all succeeded; `bitbake gateway-image`, 5105
  tasks, all succeeded.
- On the board, all as expected: `/boot/overlays/stm32-node.dtbo` (793 bytes); `dtoverlay=stm32-node` in
  `/boot/config.txt`; a node `stm32@0` under `spi@7e204000` with the right `compatible`; `spidev@0` has
  `status` = `disabled` and `/dev/spidev0.0` is gone (`/dev/spidev0.1` stays); `stm32_node` was loaded by
  udev at 4.7 s with no `modprobe`; `dmesg`: `stm32_node spi0.0: probe: chip select 0, max clock 1000000
  Hz, mode 4`.
- `mode 4` in that line: answered in step 4.4 below.
- The folder `System Volume Information` in `/boot` is created by Windows when the card is opened
  there; it is not part of the image.

**Step 4.4 (2026-10-27): one SPI transfer in `probe`.** (In step 4.5a the transfer moved from `probe`
to `read()`; this section describes the 4.4 version, and the checks and `crc16()` are still the same.)
- `stm32_node_probe` allocates a 14-byte `tx` buffer (zeros) and a 14-byte `rx` buffer with
  `devm_kzalloc()` (DMA-safe memory, not the stack), does one blocking `spi_sync_transfer()` of 14 bytes
  (`speed_hz` 0, so the SPI core uses the 1 MHz of the device-tree node), prints the bytes with `%*ph`,
  checks the marker `0xA5` and the CRC-16/CCITT-FALSE (my own `crc16()`, the code of `spi-frame-test.c`)
  and prints seq and status. It does not decode the temperature and pressure: the driver checks the
  frame and the program that reads it decides what it means (decided 2026-10-29; the first version
  printed them, with the kernel's integer-only formatting, and was hard to read). If the node does not
  answer, `probe` prints a warning and still returns 0; only a failed
  allocation fails it. The blocking call is on purpose: 14 bytes are not a bulk transfer.
- **`mode 4` explained.** In `include/uapi/linux/spi/spi.h` bit 0 is `SPI_CPHA`, bit 1 `SPI_CPOL` and
  bit 2 `SPI_CS_HIGH`, so 4 is `CS_HIGH` alone: the clock is mode 0. `drivers/spi/spi.c` (`spi_setup`)
  sets `CS_HIGH` itself when the controller uses a GPIO descriptor for chip select, because the
  descriptor holds the active-low polarity. The good CRCs below show that the clock mode and the
  chip-select polarity are right. Where the chip-select GPIO comes from was settled on 2026-10-31
  (see "Checks on the board" after step 4.5c): the Pi's device tree has `cs-gpios`.
- On the board (image `...rootfs-20261027144216.wic.bz2`, STM32 running): udev loaded the module at
  4.64 s with no `modprobe`; `dmesg` showed `good frame: seq=97 status=0 T=20.17 C P=1011.35 hPa`, and
  the bytes decode by hand to the same numbers. Four more `rmmod`/`modprobe` rounds: all 5 frames good.
- **The stale first read, seen from the driver.** Each read returned the frame of about one read
  earlier: reads at 4.7 s, 90.3 s, 123.1 s, 138.6 s and 148.3 s returned seq 97, 97, 183, 217 and 232,
  while the newest frame at those times was about 97, 184, 217 and 232 (one frame per 0.99 s). So the
  node loads the newest frame right after each transaction and a later read gets that old one. Step 4.5
  decides the policy (read twice and keep the second, or refresh the buffer on the node).
- The cleaned-up version (2026-10-29), flashed: `dmesg` showed the frames as expected, so the node,
  the wires and the driver work.
- Not verified: the clock on the wire (no logic analyzer capture of the driver; the SPI core
  replaces `speed_hz = 0` by the 1 MHz of the device tree, but the real divider result was not
  measured); `spi-frame-test` cannot run on this image, because `/dev/spidev0.0` is gone.

**Step 4.5a (2026-10-29): the character device.** (ADR-0018)
- `probe` no longer talks to the node. It saves the `spi_device` in a global pointer `node_spi` (one
  node only; with two, a struct found with `container_of()` would be needed, because `read()` is
  called with fixed arguments and `probe`'s local variables are gone) and calls `misc_register()` on
  a `miscdevice` named `stm32_sensor_node`; `remove` calls `misc_deregister()` first and then clears
  the pointer. A misc device is the simplest character device: the kernel makes the `/dev` file and
  calls the `.read` of the `file_operations` table (`.owner = THIS_MODULE`).
- `stm32_node_read()` returns `-ENODEV` if the device is gone, `-EINVAL` if the program asks for fewer
  than 14 bytes, then allocates `tx` and `rx` with `kzalloc()` (freed at the end through one `out:`
  label), does the transfer, returns `-EIO` for a wrong marker or CRC, copies the frame with
  `copy_to_user()` (`-EFAULT` on a bad address) and returns 14. The driver checks the frame; the
  program decodes it.
- On the board: `/dev/stm32_sensor_node` exists (`crw------- root`, major 10, minor 265); three
  reads with `dd bs=14 count=1 | hexdump -C` gave frames starting `a5`, with sequence 72, 74 and 96
  (19.65 C, 1014.58 hPa decoded by hand from the first); `bs=4` gives `Invalid argument`; `rmmod`
  removes the file and `modprobe` makes it again.
- **The `-EIO` path, seen with the node off:** the first reads on the new image returned
  `Input/output error` because the STM32 was not connected and not running (told by me, not seen
  in a log: the driver does not say whether the marker or the CRC was wrong). Five reads in a loop,
  back to back, were all good once it was running.
- BusyBox has no `od -A`/`-t`; `hexdump -C` is in the image. `cat` on the file never ends, because
  `read()` never returns 0; `dd bs=14 count=1` reads one frame.
- Tested on 2026-10-31: with `sleep 300 < /dev/stm32_sensor_node &` holding the file open,
  `lsmod` showed "used by 1" and `rmmod stm32_node` answered `Module stm32_node is in use`; after
  `kill %1` the `rmmod` worked and `modprobe` made the file again (`.owner = THIS_MODULE` works).

**Step 4.5b (2026-10-29): the minimum gap.**
- `stm32_node_read_frame()` takes a mutex (`frame_lock`), computes how long ago the previous
  transfer ended (`ktime_us_delta(ktime_get(), last_transfer_end)`) and, if that is less than
  `MIN_GAP_US` = 200, sleeps the missing time with `usleep_range()`; then it does the transfer and
  stores the end time. The mutex makes two simultaneous readers take turns, each with its own gap. A
  program that reads once a second never waits.
- Why 200 us: Phase 2 saw gaps of 154 to 228 us between back-to-back reads from Python and 30000 such
  reads were good, so 154 us is known to work; 200 us is a margin I chose above it. The re-arm time
  of the node was never measured (only that upper bound).
- On the board: 500 reads one after another (500 `dd` processes), `ok=500 fail=0`; 8 readers at
  once, 10 reads each, no failure. **Not verified:** that the driver really leaves 200 us on the wire
  (it needs a logic analyzer capture of NSS with a reader fast enough to reach the limit); the tests
  show only that nothing broke.
- **The first read after the node restarts is the placeholder:** `a5 01 00 00 ... 10 96`, that is
  `seq=0`, `status=1` (`NO_READING`), T and P zero, a valid CRC. The next read was `seq=36`. This is
  the stale first read of ADR-0010 in its worst form; step 4.5c decides what to do about it.

**Step 4.5c (2026-10-29): the stale first read.** (ADR-0019)
- `read()` calls `stm32_node_read_frame()` twice and checks only the second frame. The first transfer
  is thrown away; its side effect is that the node reloads its output buffer when it ends, and the
  second transfer, at least `MIN_GAP_US` later, gets that newest frame. Cost: about 0.4 ms per read.
  The options not taken: a firmware change to refresh the buffer (B), and leaving it to the programs
  (C).
- On the board: a read, 30 s of idle and a read gave `seq` 194 and 224 (a fresh frame; before the
  change the second read would have been about the frame of the first); after a reset of the Nucleo
  and 3 s of waiting, the first read gave `seq=3`, `status=0`; 8 readers at once, 10 reads each, no
  failure. The 500 sequential reads were not repeated with this change.
- The driver does not decode `status`: within the first second after a node start the frame can
  still be the placeholder (`status=1`), and the program has to look at it.

**Checks on the board (2026-10-31).** I read the SPI controller driver and the SPI core in the
mainline 6.18 source in the build folder (the Pi runs the Raspberry Pi fork of 6.18.33, so each point
below was checked on the board).
- **Chip select.** `dmesg | grep native-CS` printed nothing, so `spi-bcm2835` does not build the
  chip-select GPIO itself. The Pi's device tree gives it: `/proc/device-tree/soc/spi@7e204000/cs-gpios`
  holds two entries, GPIO 8 (chip select 0, Pi pin 24, where the STM32's NSS is wired) and GPIO 7 (chip
  select 1), both with flag 1 = active low. That is why the SPI core sets `SPI_CS_HIGH` and `probe`
  prints `mode 4`.
- **Interrupt mode.** In the source a transfer under 96 bytes is never done with DMA
  (`BCM2835_SPI_DMA_MIN_LENGTH`), and polling is only used under about 3 bytes at 1 MHz, so my 14-byte
  transfers use the interrupt. On the board the count of `3f204000.spi` in `/proc/interrupts` went from
  0 to 10 after 5 reads, which are 10 transfers: one interrupt per transfer. The node also lists `dmas`,
  so DMA exists for this controller; 14 bytes are too short for it. In this mode the source says
  there is one idle clock after each byte (9 clock periods per byte, about 126 us for the frame at
  1 MHz); I derived that from the source, I did not measure it with the driver.
- **Clock request.** In the SPI core, a transfer with `speed_hz = 0` gets `spi->max_speed_hz`, the
  1 MHz of the device-tree node. The controller driver then divides its input clock by an even number,
  so the real clock is at or just below 1 MHz. The exact value is not measured.
- **Overlay dependency (from reading, not tested).** The overlay adds `stm32@0` under `spi0` but does not
  switch `spi0` on; the base tree has it `disabled`. So `dtparam=spi=on` (`ENABLE_SPI_BUS`) is a
  prerequisite of the driver.
- **`rmmod`:** see the end of step 4.5a.

**Step 4.6a (2026-10-31): the layers.** The repo `meta-openembedded` is cloned into `~/yocto/` (branch
`wrynose`, commit `c734c2cb9713`, 2026-10-29). Mosquitto is not in `meta-oe` but in `meta-networking`
(`mosquitto_2.1.2.bb`), which depends on `meta-oe` and `meta-python`; the three layers were added with
`bitbake-layers add-layer`, which checked the dependencies, and `linux-gateway/conf/bblayers.conf` has
the same seven layers. `meta-python` adds no Python to the image. (ADR-0020.)

**Step 4.6b (2026-10-31): the broker in the image.**
- `meta-gateway/recipes-connectivity/mosquitto/mosquitto_%.bbappend` removes `ssl` and `websockets`
  from `PACKAGECONFIG` of that recipe and installs my `mosquitto.conf` over the sample one (my
  `do_install:append` runs after the recipe's). The config has two lines: `listener 1883 127.0.0.1`
  and `allow_anonymous true`, written explicitly because I read the 2.x defaults only in forum posts.
  `gateway-image.bb` lists `mosquitto` and `mosquitto-clients`.
- Checks on the build: `bitbake-layers show-appends` lists the `.bbappend`; `PACKAGECONFIG` is empty;
  the root filesystem has my config and `S30mosquitto` links; no zero-byte files. 82 packages (76
  before), root filesystem 39 MB (37), image 36M compressed. The broker links only `libm`, `libcjson`
  and `libc`. OpenSSL was already in the image (`wpa_supplicant` links `libssl` and `libcrypto`,
  `sshd` links `libcrypto`), so removing `ssl` saved no package; ADR-0020 says so.
- On the board (image `...rootfs-20261031163029.wic.bz2`): the broker runs as the user `mosquitto`
  (started by `S30mosquitto`). `/proc/net/tcp` shows it listening on `127.0.0.1:1883` only and
  `sshd` on `0.0.0.0:22`; there is no `/proc/net/tcp6` (no IPv6 in this kernel). `netstat` is not in
  the image, so `/proc/net/tcp` is the way to look (ports and addresses are hex; `0A` is LISTEN).
  The Pi had the address 192.168.1.4. I reported the broker test with `mosquitto_pub`/`mosquitto_sub`,
  the closed port 1883 seen from the laptop and the driver frame as passed; I did not paste those
  outputs into this document.
- Not done: broker logging (there is `busybox-syslog` in the image, `log_dest syslog` is untried). The
  SSH tunnel test was done later, see step 4.6c.

**Step 4.6c (2026-10-31 to 2026-11-01): the publisher `gateway-publisher`.** One C file in
`meta-gateway/recipes-app/gateway-publisher/`, built in five pieces; each was tested on the board before
the next one (ADR-0020, ADR-0021, ADR-0022).
- **Piece 1: read and decode.** `read()` on `/dev/stm32_sensor_node` returns the checked 14 bytes; the
  program decodes them byte by byte (little-endian, temperature signed). It does not check marker and CRC,
  the driver does. On the board: `seq=14 status=0 T=20.38 C P=1016.55 hPa`.
- **Piece 2: the JSON.** Built with `snprintf` from integers only: the frame holds hundredths of a degree
  and pascals, and a pascal is 0.01 hPa, so both print with the same function. The sign is written by hand
  (`-5 / 100` is 0 in C) and the magnitude is 64-bit. A status other than 0 gives `{"seq":N,"status":S}`
  without numbers. A message that does not fit the 96-byte buffer is never sent (the longest is 71
  characters). 13 checks on the PC; on the board `{"seq":596,"status":0,"temp_c":20.37,"press_hpa":1016.50}`.
- **Piece 3: connect and publish.** libmosquitto: `lib_init`, `new` (client ID `gateway-publisher`, clean
  session), `connect` (localhost:1883, keepalive 60 s), `loop_start` (a thread for pings and reconnect),
  `publish` (QoS 0, no retain). The header is `<mosquitto/libmosquitto.h>` because the umbrella header of
  2.1 pulls in cJSON. `mosquitto_strerror` is in a library that is not in the image.
  A `mosquitto_sub` on the Pi received `gateway/stm32/bmp280 {"seq":1252,...}`.
- **Piece 4: the loop.** Read every 200 ms, publish when `seq` changed, and update the remembered `seq` only
  after a successful publish. Read and publish failures are logged once when they start and once when they
  end. SIGINT and SIGTERM only set a flag; the loop leaves and closes the connection. Four tests passed:
  steady one message per second, node off and back on, broker stopped and started, Ctrl+C.
- **Piece 5: start at boot.** `gateway-publisher.init` (start, stop, restart with `start-stop-daemon`) and
  `update-rc.d` with `defaults 40 20`: `S40gateway-publisher` in the start folders and `K20` in the stop
  folders. At start the program waits (every 2 s) for the device file and the broker, logging the first
  failure only. Messages go to syslog.
- **Tests of piece 5 on the board** (image `gateway-image...20261101`): the program runs after boot without a
  manual start, with messages once per second and `seq` without gaps; `stop` removes the process and the pid
  file and logs `stopped`; a second `start` does nothing; the node powered on after the Pi gave `read
  failed` and then `read works again` without a restart; with the broker stopped, one log line and the
  program keeps running, then `connected to the broker` when the broker returns.
- **What the board showed that I had not expected.** `logread` does not work (`can't find syslogd buffer`);
  the log is `/var/log/messages`, and its dates are not real because the Pi has no clock. After a failed
  connect `strerror(errno)` said "Bad file descriptor" with the broker simply stopped; the program now logs
  the library's code (`failed (code 14)`). My explanation (the library overwrites `errno`) is a guess.
  `dmesg` has no `good frame` line any more.
- **Wi-Fi power save, seen at boot.** `dmesg` shows `power save enabled` at 5.79 s and `power save
  disabled` at 11.47 s, so the line in `interfaces` is applied at every boot.
- **Two single `read failed` lines with the node running** (about 4 s apart, each followed by `read works
  again` in the next read), within about two minutes. I do not know the cause, and the driver does not
  say whether it was the marker or the CRC. No message was lost (`seq` had no gap).
- **The SSH tunnel from the laptop (2026-11-01).** Mosquitto for Windows (`mosquitto_sub.exe`, installed
  without the service) on the laptop. Window A: `ssh -i <key> -L 11883:localhost:1883 root@192.168.1.4`
  (laptop port 11883, so it cannot clash with a local broker). Window B: `mosquitto_sub -h 127.0.0.1 -p
  11883 -t 'gateway/#' -v` received one message per second (`seq` 1211 to 1217 in the paste). After `exit`
  in window A the messages stopped. Without the tunnel, `mosquitto_sub -h 192.168.1.4 -p 1883` gave
  "actively refused it". So the broker is reachable from the laptop only through the SSH login.
  (The comment in `mosquitto.conf` gives the example `ssh -L 1883:localhost:1883`; I used 11883 on the
  laptop.)
- **Not verified:** the shutdown order and a frame with a bad CRC produced on purpose; see
  "Verification status".

**How the driver is found and loaded (board, 2026-11-01), and the boot scripts (build folder,
2026-11-02).**
- `/sys/bus/spi/devices/` has `spi0.0` (mine) and `spi0.1` (the `spidev@1` node that stays). The
  `modalias` of `spi0.0` is `spi:stm32-sensor-node`, and `modules.alias` has that alias for `stm32_node`
  (plus two `of:` aliases from the `of_match_table`, which this device does not use). The `driver` link of
  `spi0.0` points to `stm32_node`. There is no `/etc/modules` and no `/etc/modules-load.d`.
- With the publisher stopped the module count was 0. After `rmmod stm32_node`, `spi0.0` stayed without a
  driver and the device file was gone. `echo add > /sys/bus/spi/devices/spi0.0/uevent` loaded the module
  again with no `modprobe`, `probe` printed its line, and the device file came back (major 10, minor 265).
  `udevd` was the only program running that reacts to such an event; I did not watch it with
  `udevadm monitor`.
- The SPI peripheral's driver is `spi-bcm2835` (the `driver` link of `3f204000.spi`), and it is a module,
  like `spidev`. The interrupt count of `3f204000.spi` kept growing and the DMA interrupt lines hardly
  moved, which fits the interrupt mode of the checks of 2026-10-31. The time between my two looks was
  not measured, so this gives no rate.
- Read in the root filesystem folder of the build, not on the Pi: `/etc/inittab` has `id:5:initdefault:`
  (default runlevel 5) and runs `/etc/init.d/rcS` first. In `rcS.d`, `S04udev` starts `udevd -d` and then
  runs `udevadm trigger --action=add` and `udevadm settle`, which replays the "add" events of the devices
  the kernel made before udev started; that is how the module is loaded at boot. `rc2.d` has `S01networking`,
  `S09sshd`, `S20syslog`, `S30mosquitto`, `S40gateway-publisher`. `rc6.d` has `K09sshd`, then
  `K20dbus-1`, `K20gateway-publisher`, `K20syslog` (equal numbers run in name order, as far as I know),
  then `K30mosquitto`. The only `respawn` line in `inittab` is the serial login.

All planned steps are done. Small open item: the shutdown order on the board (the kill test of the
publisher was done on 2026-11-03).
Phase 3 leftovers: `kbd` and the audio line left as they are,
read-only root not done.

## Bring-up log (history)

Dated records of how the first images were built and brought up (2026-10-18 to 2026-10-24): the
build of the first image `core-image-base`, its first boot, Wi-Fi typed on the board, and the first
SPI test. Some of it describes states that no longer exist. The current state is in the sections
above ("Build configuration", "The image recipe `gateway-image`", the two Wi-Fi sections and
"Phase 4: the kernel driver").

### Build result (`bitbake core-image-base`, 2026-10-18)

- First long run 4 h 12 min (ended on the perl check, ADR-0014); last run 8 min 43 s with
  5291 of 5695 tasks reused from the cache. Build folder 63 GB. Details in ADR-0011.
- Output in `build/tmp/deploy/images/raspberrypi0-2w-64/`: the image
  `core-image-base-raspberrypi0-2w-64.rootfs.wic.bz2` (79 MB compressed) with a `.bmap`
  file, the kernel (Linux 6.18.33), the device tree `bcm2710-rpi-zero-2.dtb` and
  `bootfiles/`.
- 2026-10-22: second build with `ssh-server-openssh` (ADR-0015): 2015 packages, 80.7 MB
  compressed. The first run of it had seven 0-byte OpenSSH programs in the image; a forced
  `bitbake -f -c install openssh` and a new `bitbake core-image-base` fixed it (ADR-0015).
  The image flashed for the SSH test is `...rootfs-20261022155006.wic.bz2`.
- 2026-10-22: third build, with the layer `meta-gateway` (ADR-0016): 78 MiB compressed,
  `...rootfs-20261022194428.wic.bz2`; no zero-byte file in the root filesystem folder outside
  `/etc`, `/var` and `/usr/share`.
- 2026-10-23: builds with `ENABLE_SPI_BUS` (`...rootfs-20261023093302.wic.bz2`; `config.txt`
  line `dtparam=spi=on` checked in `deploy/bootfiles/` and on the board), with the Wi-Fi key
  from a folder outside the repo (`...rootfs-20261023095901.wic.bz2`, 78 MiB), and with the
  package `spi-frame-test`. The last one was flashed for the SPI test. These images contain
  the Wi-Fi key: they and the build folder must not be shared.
- 2026-10-24: `bitbake gateway-image` (ADR-0017), the image recipe of my own. Last build
  `gateway-image-raspberrypi0-2w-64.rootfs-20261024145944.wic.bz2`: 37 MB root filesystem,
  76 packages, 35 MiB compressed (`core-image-base`: 142 MB, 2015 packages, 78 MiB). Flashed
  and tested: boots, `wlan0` up, `/dev/spidev0.0`, 10 of 10 frames. The steps in between are in
  ADR-0017.

### What is in the image

This describes the first image, `core-image-base`. The current image, `gateway-image`, is
described above, in "The image recipe `gateway-image`". Read from the package manifest (2008 packages), the root
filesystem folder (142 MB) and the boot files in `deploy/` (the first boot below checked part
of it on the board):

- Boot partition (FAT): the Pi firmware, `config.txt`, `cmdline.txt`, the kernel and the
  device tree. `ENABLE_UART = "1"` produced `enable_uart=1` in `config.txt` and
  `console=serial0,115200` in the `cmdline.txt` of `deploy/bootfiles/`. That is **not** what
  the kernel received: its command line had `console=ttyS0,115200` (see "First boot").
  `cmdline.txt` also has `root=/dev/mmcblk0p2 rootfstype=ext4 rootwait`.
- Root partition (ext4): busybox (provides `ls` and the other basic commands; there is no
  `coreutils`), **sysvinit** as init (no systemd), `wpa-supplicant`, `iw`, the Wi-Fi firmware
  `linux-firmware-rpidistro-bcm43436`, and the kernel modules (including `spidev`).
- `/etc/inittab` starts a login prompt on `ttyS0` at 115200 baud. With the empty root
  password, `root` logs in without a password.
- The first image (2008 packages) had no SSH server; the current one (2015 packages) has
  OpenSSH (ADR-0015). Not in the image: perl, systemd, and a package manager (no `rpm`, `dnf`,
  `opkg` or `apt` in the manifest), so every change to the software is a rebuild and a new flash.
- On the board, `/etc/fstab` ends with `/dev/mmcblk0p1  /boot  vfat  defaults  0  0`. That
  line is not in the `rootfs/` folder of the build: it is added when the image is made. So
  partition 1 **is mounted** on `/boot`, read-write. It holds `kernel8.img` (27,052,544 bytes,
  the same size as the kernel `Image` of the build), the firmware files (all variants of
  `start*.elf` and `fixup*.dat`, of which this board uses `start.elf` and `fixup.dat`),
  `config.txt`, `cmdline.txt`, the `.dtb` and `overlays/`. The files read from the board
  match the ones in `deploy/bootfiles/`.

### First boot (2026-10-21)

Flashing: the image was decompressed from the `.wic.bz2` to `gateway.wic` (380 MiB, MBR
table; partition 1 FAT32 of 130 MiB from sector 8192, partition 2 Linux of 244 MiB from
sector 278528) and written to a 32 GB microSD with Raspberry Pi Imager ("Use custom",
without its customisation settings). Windows then showed the two partitions with the same
sizes as `fdisk` on the image (136,314,880 and 256,271,360 bytes).

Console: an FT232 USB-UART adapter, with its jumper on VCCIO-3V3 (3.3 V signals), on header
pins 6 (GND), 8 (Pi TX) and 10 (Pi RX); Tera Term at 115200, 8 data bits, no parity, 1 stop
bit.

What the boot log shows (times are the kernel's, in seconds):

- Kernel `6.18.33-v8`, built with `aarch64-poky-linux-gcc 15.3.0`; machine model
  "Raspberry Pi Zero 2 W Rev 1.0" (from the device tree); 4 CPUs.
- The kernel's command line ended with `dwc_otg.lpm_enable=0 console=ttyS0,115200
  root=/dev/mmcblk0p2 rootfstype=ext4 rootwait net.ifnames=0`, after options added by the
  firmware (`coherent_pool`, `8250.nr_uarts=1`, `smsc95xx.macaddr`, `vc_mem.*` and others).
  **The console is `ttyS0`** (the mini UART, `3f215040`), and `/etc/inittab` starts the login
  on `ttyS0`: **they are the same port.** The `cmdline.txt` inside partition 1 (read later
  on the board) says `console=serial0,115200`, and the kernel received `ttyS0`. So the
  firmware replaces `serial0` by the real port: I did not watch it do that, but nothing else
  sits between the file and the kernel.
- Root filesystem: `Waiting for root device /dev/mmcblk0p2` at 3.869 (`rootwait`), the SD
  card found at 3.946, `mmcblk0: p1 p2` at 3.958, ext4 mounted **read-only** at 4.029,
  `Run /sbin/init` at 4.060, remounted read-write at 11.643.
- `INIT: version 3.14` (sysvinit); login prompt about 13 s after the kernel started; `root`
  logs in without a password and gets a busybox shell. The banner says Poky 6.0.4.
- No U-Boot output before `Booting Linux`, and `RPI_USE_U_BOOT` is not set: the Pi firmware
  loads the kernel directly.
- Wi-Fi: the `brcmfmac` driver loaded the chip firmware (`BCM43430/2`, version 9.88.4.77) and
  the Bluetooth chip got its patch. No connection was made at that boot (see "Wi-Fi and SSH").
- Memory: 154,540K of 458,752K available, because 256 MiB were reserved as a CMA pool (for the
  GPU/camera; since 2026-10-27 the pool is 64 MiB and 350,660K are available). The clock after boot was `Mar 9 2018` (no battery clock, no network time).
- Messages that did not stop the boot, causes not investigated: `/usr/bin/psplash: not
  found` (`S00psplash.sh`), `ip: SIOCGIFFLAGS: No such device` twice during network start,
  `dbus: Unknown username "pipewire"`, `brcmf_c_process_txcap_blob: no txcap_blob available`.

### Wi-Fi and SSH (2026-10-22, ADR-0015)

**Wi-Fi, typed on the board** over the serial console. The image has `wpa_supplicant` 2.11,
`iw` and the busybox DHCP client. `wlan0` is in `/etc/network/interfaces` but is **not**
`auto`, and `/etc/wpa_supplicant.conf` held only a placeholder. I wrote the file with the
header lines and `country=GR`, added the network with `wpa_passphrase` (the password typed at
its prompt; the plain-text comment line it writes is deleted), and ran `ifup wlan0`. Results:

- The scan listed the network and about 13 others, all on 2.4 GHz (2412 to 2462 MHz); mine on
  2462 MHz (channel 11), signal -34 dBm, receive rate 65 Mbit/s.
- DHCP gave `192.168.1.4/24` from the router `192.168.1.1`, lease 86,400 s; default route via
  the router; DNS added from the lease.
- `ping 192.168.1.1`: 3 of 3, about 5.7 ms. `ping 1.1.1.1`: 3 of 3, about 15 ms. `ping
  example.com` resolved a name and answered.
- Warnings: the hook starts `wpa_supplicant` with the old `wext` interface
  (`wpa-driver wext`); the kernel warned that wireless extensions will stop working for newer
  hardware, and `wpa_supplicant` printed `ioctl[SIOCSIWENCODEEXT]: Invalid argument` twice.
  The connection worked; I do not know what the two errors affected.
- The settings stay across reboots but a reflash erases them. `wlan0` did not start at boot in
  this first image; the layer `meta-gateway` (above) fixed that.

**SSH.** `IMAGE_FEATURES += "ssh-server-openssh"` adds OpenSSH 10.3p1 (`sshd`, `ssh`, `scp`,
`sftp-server`, `ssh-keygen`; 7 more packages). In this first image `sshd_config` had `PermitRootLogin yes` and
`PermitEmptyPasswords yes` (from the two `allow-*` features), so I set a root password with
`passwd` after every flash (both features are gone: root has a baked-in password hash since 2026-10-24 and
SSH is key-only since 2026-10-27). `S09sshd` starts the server at boot.

**The first OpenSSH image did not work.** `ssh` to the Pi answered `Connection refused`; on
the board there was no `sshd` process, no host keys and no log line. A trace of
`/etc/init.d/sshd start` showed that the script exits silently after `test -x
/usr/sbin/sshd`. In the build, `/usr/sbin/sshd` and six more programs were 0 bytes in the
`image/` folder of the openssh recipe, while the compiled programs in its source folder were
complete. The details and my hypothesis (a race in a parallel `make install`, not proven)
are in ADR-0015. `bitbake -f -c install openssh` and a new `bitbake core-image-base` gave
complete files (package 654,588 bytes instead of 29,913), and an SSH login from Windows then
worked.

### SPI and the test tool (2026-10-24)

`ENABLE_SPI_BUS = "1"` makes `config.txt` contain `dtparam=spi=on`; on the board `/dev/spidev0.0`
and `/dev/spidev0.1` exist. The image has no Python, so I wrote `spi-frame-test` in C
(`linux-gateway/meta-gateway/recipes-test/spi-frame-test/`): one SPI transfer of 14 bytes at
1 MHz in mode 0 through `spidev`, then the checks of `tools/spi_frame_test.py` (marker `A5`,
CRC-16). It is a bring-up tool, not the Phase 4 driver.

Wired as in the README table (Pi pins 24, 23, 21, 19, 25), the Nucleo running the Phase 2
firmware, `spi-frame-test 10` printed 10 lines, all with a valid CRC:

- Frame 0: `seq=0 status=1` (NO_READING), `T=0.00 P=0.00`. The next frame has `seq=26`.
  This is consistent with the stale first read of ADR-0010 (an old frame on the first read after
  a long idle); I did not measure the mechanism in this run.
- Frames 1 to 9: `seq` 26 to 34 (one more per second), `status=0`, `T=21.57 to 21.58 C`,
  `P=1015.69 to 1015.71 hPa`.

A second run on 2026-10-24, on the `gateway-image` build (modules `spi-bcm2835` and `spidev`
loaded by udev), gave 10 of 10 valid frames again, `seq` 183 to 191, `T=21.90 to 21.91 C`,
`P=1014.99 to 1015.02 hPa`. Frame 0 was byte for byte the same as in the first run
(`A5 01 00 00 ... 10 96`, `seq=0`, `status=1`): the first read after a long idle returned the
frame the node loaded at boot, in both runs. This is for the Phase 4 decision about the stale
first read; nothing is decided.
