Marios-Dimopoulos/stm32-freertos-iot-gateway/docs/budget.md

# Hardware Budget

Already owned (not counted against the 50 EUR budget):
- STM32 Nucleo-F411RE
- Raspberry Pi Zero 2 W

## Additional equipment (budget: 50 EUR total)

| Item | Purpose | Estimated cost | Status |
|---|---|---|---|
| USB Logic Analyzer, FX2LP-based, 8ch/24MHz | I2C/SPI signal analysis via sigrok/PulseView | €8.50 – €30.80 | Not purchased |
| BMP280 sensor | Temperature/pressure over I2C | €12.00 – €15.00 | Not purchased |
| MPU-6050 | IMU — gyro + accelerometer over I2C | €3.00 – €5.00 | Dropped from the design (2026-09-30), will not be bought |
| Jumper wires / breadboard | Wiring between boards | €4.00 – €7.00 | Not purchased |
| **Total (excl. MPU-6050)** | | **~€24.50 – €52.80** | |

Note: the low end of the total slightly undercuts budget; the high end
slightly exceeds it depending on where items are sourced. Flag actual purchase prices here once bought, and
update the running total.

## Actual purchases

*(fill in as items are bought — item, price paid, source, date)*
