Marios-Dimopoulos/stm32-freertos-iot-gateway/docs/plan.md

# Στρατηγική Ανάπτυξης Δεξιοτήτων Ενσωματωμένων Συστημάτων

## Σχεδιασμός και Υλοποίηση Ετερογενούς Κατανεμημένης Αρχιτεκτονικής Υλικού και Λογισμικού

---

## Εισαγωγή στο Σύγχρονο Τοπίο των Ενσωματωμένων Συστημάτων και Ανάλυση Αγοράς

Η εξέλιξη των ενσωματωμένων συστημάτων (embedded systems) κατά την τρέχουσα δεκαετία χαρακτηρίζεται από μια πρωτοφανή σύγκλιση της ηλεκτρονικής μηχανικής χαμηλού επιπέδου (low-level hardware engineering) με τις προηγμένες τεχνολογίες δικτύωσης και τα πολύπλοκα λειτουργικά συστήματα. Σύμφωνα με αναλύσεις της αγοράς εργασίας και τις τάσεις που διαμορφώνονται για το 2026, η παραδοσιακή προσέγγιση της συγγραφής κώδικα "bare-metal" σε μικροελεγκτές, αν και παραμένει το θεμέλιο της κατανόησης του υλικού, δεν επαρκεί πλέον από μόνη της για την εξασφάλιση θέσεων εργασίας υψηλών απαιτήσεων και αποδοχών. Η σύγχρονη βιομηχανία του Internet of Things (IoT), η αυτοκινητοβιομηχανία, τα συστήματα βιομηχανικού αυτοματισμού και ο ιατρικός εξοπλισμός απαιτούν τη χρήση διασυνδεδεμένων συσκευών που μπορούν να επεξεργάζονται τεράστιους όγκους δεδομένων τοπικά (edge computing), διατηρώντας ταυτόχρονα αυστηρούς χρονικούς περιορισμούς (real-time constraints).

Σε αυτό το διαρκώς μεταβαλλόμενο τεχνολογικό οικοσύστημα, οι ρόλοι του Embedded Software Engineer και του Embedded Linux Engineer έχουν καταστεί ιδιαίτερα κρίσιμοι, παρουσιάζοντας μια ταχέως αυξανόμενη ζήτηση που υπερβαίνει τη διαθέσιμη προσφορά εξειδικευμένων μηχανικών. Οι υπεύθυνοι προσλήψεων (hiring managers) αναζητούν μηχανικούς οι οποίοι κατέχουν θεωρητική και πρακτική γνώση σε Λειτουργικά Συστήματα Πραγματικού Χρόνου (RTOS), όπως το FreeRTOS και το Zephyr, καθώς και συστήματα Embedded Linux, τα οποία κατασκευάζονται και παραμετροποιούνται μέσω εργαλείων βιομηχανικού προτύπου όπως το Yocto Project και το Buildroot. Παράλληλα, η ικανότητα ανάπτυξης προσαρμοσμένων προγραμμάτων οδήγησης για τον πυρήνα του Linux (Linux Kernel Device Drivers) και η ικανότητα άμεσης ανάλυσης ψηφιακών σημάτων (hardware debugging) μέσω αναλυτών λογικής αποτελούν δεξιότητες που διαχωρίζουν τους κορυφαίους υποψηφίους από τον μέσο όρο.

Η παρούσα ερευνητική αναφορά στοχεύει στον σχεδιασμό μιας ολοκληρωμένης στρατηγικής εκπαίδευσης και πρακτικής εξάσκησης, σχεδιασμένης ειδικά για τελειόφοιτους φοιτητές πανεπιστημιακών τμημάτων Ηλεκτρολόγων Μηχανικών και Μηχανικών Υπολογιστών. Λαμβάνοντας υπόψη ένα προφίλ με σταθερό ακαδημαϊκό υπόβαθρο στους μικροεπεξεργαστές, στα λειτουργικά συστήματα, στην αρχιτεκτονική υπολογιστών και στον προγραμματισμό C/Assembly, το παρόν έγγραφο προτείνει ένα εξαιρετικά λεπτομερές, κλιμακούμενο έργο (project). Το προτεινόμενο έργο αξιοποιεί τον διαθέσιμο εξοπλισμό (έναν μικροελεγκτή STM32 Nucleo-F411RE και έναν μικροϋπολογιστή Raspberry Pi Zero 2 W) και παραμένει εντός ενός αυστηρού προϋπολογισμού των 50 ευρώ για την προμήθεια του απαραίτητου περιφερειακού εξοπλισμού. Η ανάλυση εκτείνεται σε βάθος τόσο στο υλικό (hardware) όσο και στο λογισμικό (software), καλύπτοντας τη στατική διαχείριση μνήμης στο FreeRTOS, τις μεταφορές δεδομένων μέσω Άμεσης Προσπέλασης Μνήμης (DMA), τη συγγραφή οδηγών πυρήνα Linux (Kernel Modules), την ανάλυση σημάτων με χρήση του λογισμικού Sigrok και του PulseView, και τη χρήση του πρωτοκόλλου MQTT για την τελική δρομολόγηση των δεδομένων.

---

## Αξιολόγηση Υφιστάμενων Δεξιοτήτων και Γεφύρωση του Χάσματος με τη Βιομηχανία

Πριν από την παρουσίαση της αρχιτεκτονικής του προτεινόμενου έργου, είναι ζωτικής σημασίας να καθοριστεί η διαφορά μεταξύ των ακαδημαϊκών γνώσεων ενός τελειόφοιτου μηχανικού και των απαιτήσεων παραγωγής της βιομηχανίας. Η πανεπιστημιακή εκπαίδευση, ειδικά σε μαθήματα μικροεπεξεργαστών και ενσωματωμένων συστημάτων πραγματικού χρόνου, προσφέρει άριστη κατανόηση της θεωρίας. Η μελέτη φύλλων δεδομένων (datasheets), ο έλεγχος περιφερειακών (timers, PWM, GPIO), η συγγραφή Assembly και C, καθώς και η χρήση διαύλων UART και I2C συνιστούν την απαραίτητη βάση. Ομοίως, στα λειτουργικά συστήματα, η χρήση διεργασιών, νημάτων (threads) και βασικών εργαλείων τερματικού Linux διαμορφώνει τον προγραμματιστικό τρόπο σκέψης.

Ωστόσο, στο περιβάλλον της πραγματικής βιομηχανικής παραγωγής, οι μηχανικοί δεν χρησιμοποιούν έτοιμα λειτουργικά συστήματα γενικού σκοπού (όπως το Ubuntu ή το προ-εγκατεστημένο Raspberry Pi OS) για την ανάπτυξη προϊόντων. Η χρήση τέτοιων συστημάτων εγκυμονεί κινδύνους ασφαλείας, αυξάνει τους χρόνους εκκίνησης (boot times) και καταναλώνει υπερβολικούς υπολογιστικούς πόρους. Η βιομηχανία απαιτεί συστήματα λειτουργικά ελαχιστοποιημένα, δομημένα από τον πηγαίο κώδικα (source) μέσω συστημάτων δόμησης όπως το Yocto ή το Buildroot. Αντιστοίχως, στο πεδίο των μικροελεγκτών, ο απλός προγραμματισμός "super-loop" (ένας ατέρμονος βρόχος `while(1)`) αντικαθίσταται από πολύπλοκα Λειτουργικά Συστήματα Πραγματικού Χρόνου, όπου κυριαρχεί το FreeRTOS, με έμφαση στη ντετερμινιστική εκτέλεση και την αυστηρή διαχείριση της μνήμης χωρίς κατακερματισμό.

| Ακαδημαϊκό Επίπεδο / "Hobbyist" | Βιομηχανικό Επίπεδο / Επαγγελματίας Μηχανικός | Αιτιολόγηση Βιομηχανικής Επιλογής |
|---|---|---|
| Raspberry Pi OS (Raspbian) / `apt-get` | Yocto Project / Buildroot Custom Images | Μείωση επιφάνειας επιθέσεων, ταχύτερη εκκίνηση, απόλυτος έλεγχος των αδειών λογισμικού, δυνατότητα αναπαραγωγής του λειτουργικού. |
| Δυναμική Δέσμευση Μνήμης (`malloc`/`free`) | Στατική Δέσμευση (Static Memory Allocation) | Αποφυγή κατακερματισμού του σωρού (heap fragmentation), ντετερμινιστικός χρόνος εκτέλεσης, αδυναμία κατάρρευσης λόγω έλλειψης μνήμης. |
| Polling ή απλά Interrupts για μεταφορά δεδομένων | Χρήση DMA (Direct Memory Access) σε συνδυασμό με RTOS | Αποδέσμευση της CPU για την εκτέλεση άλλων διεργασιών, μέγιστη αξιοποίηση του εύρους ζώνης του διαύλου επικοινωνίας. |
| Ανάγνωση αισθητήρων μέσω User-Space (π.χ. Python/I2C tools) | Ανάπτυξη Linux Kernel Device Drivers σε C | Άμεση πρόσβαση στο υλικό, διαχείριση διακοπών σε επίπεδο πυρήνα, ενοποίηση με το υποσύστημα Device Tree του Linux. |
| Σφαλμάτωση μέσω εντολών `printf` στο τερματικό | Χρήση Logic Analyzers / Παλμογράφων / JTAG / SWD | Οπτικοποίηση ηλεκτρικών σημάτων, εντοπισμός σφαλμάτων συγχρονισμού, ανακάλυψη προβλημάτων επιπέδου υλικού (hardware layer). |

Αυτή η μετάβαση από το ακαδημαϊκό στο επαγγελματικό περιβάλλον απαιτεί πρακτική εμπειρία. Το έργο που αναλύεται στη συνέχεια έχει σχεδιαστεί για να καλύψει ακριβώς αυτό το κενό, προσομοιώνοντας την ανάπτυξη ενός πραγματικού βιομηχανικού προϊόντος IoT.

---

## Αρχιτεκτονική του Προτεινόμενου Συστήματος: Κατανεμημένο Δίκτυο Αισθητήρων και Πύλης (Edge-to-Gateway)

Η βιομηχανική πρακτική υπαγορεύει ότι διαφορετικές υπολογιστικές πλατφόρμες εξυπηρετούν ριζικά διαφορετικούς σκοπούς. Οι μικροελεγκτές (όπως ο STM32) είναι σχεδιασμένοι για άμεσο, χαμηλού επιπέδου έλεγχο υλικού, ακριβή χρονισμό σε επίπεδο μικροδευτερολέπτων, και λειτουργία με ελάχιστη κατανάλωση ενέργειας. Από την άλλη, οι μικροεπεξεργαστές (όπως ο ARM Cortex-A53 που βρίσκεται στο Raspberry Pi Zero 2 W) σχεδιάζονται για να υποστηρίζουν MMU (Memory Management Unit), λειτουργικά συστήματα πλήρους κλίμακας, ισχυρά πρωτόκολλα κρυπτογραφίας, συνδεσιμότητα δικτύου (Wi-Fi, Ethernet) και την εκτέλεση πολύπλοκων σεναρίων Python ή Node.js.

Το προτεινόμενο έργο ορίζει τη δημιουργία ενός ετερογενούς συστήματος, διαρθρωμένου σε τρία διακριτά αλλά αλληλένδετα υποσυστήματα, τα οποία θα αναπτυχθούν και θα ενσωματωθούν σταδιακά κατά τη διάρκεια των θερινών μηνών:

1. **Το Υποσύστημα Απόκτησης Δεδομένων (Sensor Node / Edge Device):** Θα υλοποιηθεί πάνω στον μικροελεγκτή STM32 Nucleo-F411RE. Αυτό το υποσύστημα θα εκτελεί το λειτουργικό σύστημα FreeRTOS. Θα είναι υπεύθυνο για την επικοινωνία με εξωτερικούς αισθητήρες περιβάλλοντος μέσω του πρωτοκόλλου I2C. Αφού επεξεργαστεί τα δεδομένα, θα τα συσκευάζει και θα τα μεταδίδει μαζικά μέσω ενός διαύλου SPI υψηλής ταχύτητας, κάνοντας χρήση του μηχανισμού DMA.

2. **Το Υποσύστημα Κεντρικής Πύλης και Δρομολόγησης (IoT Gateway):** Θα βασίζεται στο Raspberry Pi Zero 2 W. Σε αντίθεση με τη χρήση έτοιμων λειτουργικών συστημάτων, ο χρήστης θα δημιουργήσει μια προσαρμοσμένη διανομή Linux χρησιμοποιώντας το Yocto Project (ή εναλλακτικά το Buildroot). Στον πυρήνα αυτού του λειτουργικού συστήματος, θα αναπτυχθεί και θα ενσωματωθεί ένας προσαρμοσμένος οδηγός συσκευής (Linux Kernel Module) για την ασφαλή ανάγνωση των δεδομένων που καταφθάνουν μέσω του SPI. Τα δεδομένα αυτά θα καταλήγουν στο επίπεδο εφαρμογής (user-space), όπου ένας τοπικός διακομιστής (broker) του πρωτοκόλλου MQTT θα αναλαμβάνει τη διανομή τους στο δίκτυο.

3. **Το Υποσύστημα Σφαλμάτωσης και Ανάλυσης (Hardware Debugging Station):** Για την επίλυση των αναπόφευκτων προβλημάτων επικοινωνίας μεταξύ του μικροελεγκτή και του μικροεπεξεργαστή, θα χρησιμοποιηθεί ένας Αναλυτής Λογικής (Logic Analyzer) χαμηλού κόστους, συνδεδεμένος σε υπολογιστή-ξενιστή (host PC), εκτελώντας την ανοιχτού κώδικα σουίτα ανάλυσης σημάτων Sigrok και το γραφικό περιβάλλον PulseView.

Αυτή η αρχιτεκτονική δεν αποτελεί μια συνθετική ακαδημαϊκή άσκηση, αλλά τον πυρήνα σχεδιασμού συστημάτων σε βιομηχανίες τηλεμετρίας, έξυπνων κτιρίων, και βιομηχανικών αισθητήρων.

---

## Ανάλυση Υποσυστήματος 1: Ο Κόμβος Πραγματικού Χρόνου (STM32 Nucleo-F411RE & FreeRTOS)

Ο μικροελεγκτής STM32F411RE ενσωματώνει έναν ισχυρό πυρήνα ARM Cortex-M4, ο οποίος μπορεί να λειτουργήσει σε συχνότητες έως και 100MHz, διαθέτοντας μονάδα κινητής υποδιαστολής (FPU) και προηγμένο σύστημα διαχείρισης διακοπών (NVIC). Η πλατφόρμα αυτή επιλέγεται συχνά στην αγορά εργασίας για την εισαγωγή νέων μηχανικών σε αρχιτεκτονικές βιομηχανικού επιπέδου. Η λειτουργία του από προεπιλογή βασίζεται στον εσωτερικό ταλαντωτή ή σε εξωτερικό κρύσταλλο, με την κεντρική συχνότητα να διαμορφώνεται συνήθως στα 84MHz μέσω του βρόχου κλειδώματος φάσης (PLL).

### Επιλογή Αισθητήρων και Επικοινωνία I2C σε Επίπεδο Bare-Metal

Η απόκτηση περιβαλλοντικών και κινηματικών δεδομένων αποτελεί την πρωταρχική λειτουργία του κόμβου. Λαμβάνοντας υπόψη τον αυστηρό οικονομικό προϋπολογισμό των 50 ευρώ, υπάρχουν εξαιρετικές και ευρέως διαδεδομένες επιλογές στην αγορά:

- **Ο Αισθητήρας BME280 ή BMP280:** Κατασκευασμένος από τη Bosch, ο αισθητήρας BME280 αποτελεί την επιτομή της σύγχρονης τεχνολογίας MEMS, προσφέροντας μετρήσεις θερμοκρασίας, βαρομετρικής πίεσης και σχετικής υγρασίας με εντυπωσιακή ακρίβεια (π.χ. ακρίβεια υγρασίας ±3%). Επικοινωνεί με τον μικροελεγκτή είτε μέσω I2C είτε μέσω SPI, και κοστίζει συνήθως μεταξύ 10 και 15 ευρώ στα εγχώρια καταστήματα ηλεκτρονικών ειδών.
- **Ο Αισθητήρας MPU-6050:** Μια εξαιρετικά οικονομική μονάδα μέτρησης αδράνειας (IMU), που περιλαμβάνει γυροσκόπιο τριών αξόνων και επιταχυνσιόμετρο τριών αξόνων. Το κόστος της κυμαίνεται σε εξαιρετικά χαμηλά επίπεδα (κάτω των 5 ευρώ), καθιστώντας την ιδανική για πειραματισμούς με πολύπλοκα μαθηματικά φίλτρα.
- **Ο Αισθητήρας SHT45 ή AHT20:** Εναλλακτικές επιλογές αποκλειστικά για θερμοκρασία και υγρασία, με το AHT20 να προσφέρει μια προσιτή αλλά ισχυρή λύση μέσω καθαρού διαύλου I2C.

Η ενσωμάτωση του επιλεγμένου αισθητήρα (π.χ. του BME280) στο STM32F411RE απαιτεί την προσεκτική χρήση του πρωτοκόλλου I2C. Σύμφωνα με την τεκμηρίωση του κατασκευαστή, η επικοινωνία I2C1 υλοποιείται συνήθως στους ακροδέκτες PB8 (SCL) και PB9 (SDA) ή εναλλακτικά στα PA8 και PB4. Κατά την ανάπτυξη, είναι απαραίτητη η υλοποίηση ενός προγράμματος οδήγησης το οποίο θα αλληλεπιδρά άμεσα με τους καταχωρητές του αισθητήρα. Ο αναπτυσσόμενος κώδικας θα πρέπει να επιλύει προκλήσεις όπως η διαχείριση της διεύθυνσης της συσκευής (συνήθως 0x76 ή 0x77 για τον BME280 ανάλογα με τη σύνδεση του ακροδέκτη SDO), η εκκίνηση μετρήσεων με τεχνικές oversampling, και η ανάγνωση των εργοστασιακών δεδομένων βαθμονόμησης (calibration parameters) που βρίσκονται αποθηκευμένα στην εσωτερική μνήμη ROM του αισθητήρα.

| Σήμα I2C (BME280 / MPU-6050) | Λειτουργία | Σύνδεση στο Nucleo-F411RE | Αντιστοίχιση Εναλλακτικής Λειτουργίας |
|---|---|---|---|
| SDA (Serial Data Line) | Αμφίδρομη γραμμή δεδομένων | PB9 ή PB4 | I2C1_SDA |
| SCL (Serial Clock Line) | Σήμα χρονισμού (από τον master) | PB8 ή PA8 | I2C1_SCL |
| VDD | Τροφοδοσία Τάσης | 3.3V Pin | Παροχή από το Nucleo |
| GND | Γείωση | GND Pin | Κοινή Γείωση |

### Αρχιτεκτονική Λειτουργικού Συστήματος Πραγματικού Χρόνου (FreeRTOS)

Η συλλογή δεδομένων δεν λαμβάνει χώρα στον κεντρικό βρόχο της συνάρτησης `main()`. Αντιθέτως, η λειτουργικότητα επιμερίζεται σε ανεξάρτητες διεργασίες (tasks) που διαχειρίζεται ο χρονοπρογραμματιστής (scheduler) του FreeRTOS. Το FreeRTOS αποτελεί βιομηχανικό πρότυπο, χρησιμοποιούμενο σε χιλιάδες εμπορικές εφαρμογές, και η εις βάθος κατανόησή του αποτελεί απαίτηση για τη συντριπτική πλειονότητα των θέσεων εργασίας σε ενσωματωμένα συστήματα.

#### Το Πρόβλημα της Δυναμικής Δέσμευσης Μνήμης

Στο ακαδημαϊκό επίπεδο, η δέσμευση μνήμης θεωρείται δεδομένη. Οι συναρτήσεις της τυπικής βιβλιοθήκης της C (`malloc` και `free`) χρησιμοποιούνται αδιακρίτως. Στο περιβάλλον των ενσωματωμένων συστημάτων, ωστόσο, η δυναμική δέσμευση εγκυμονεί καταστροφικούς κινδύνους. Οι μικροελεγκτές, όπως ο F411RE, διαθέτουν ελάχιστη μνήμη RAM (SRAM της τάξης των 128KB).

Όταν δημιουργούνται και καταστρέφονται αντικείμενα του FreeRTOS (όπως Tasks, Queues, Mutexes, και Semaphores) κατά τη διάρκεια της εκτέλεσης (run-time), η μνήμη δεσμεύεται σε διαφορετικά μεγέθη. Με την πάροδο του χρόνου — συσκευές IoT σχεδιάζονται για να λειτουργούν αδιάλειπτα για μήνες ή χρόνια — ο σωρός (heap) κατακερματίζεται (heap fragmentation). Αυτό σημαίνει ότι ενώ μπορεί να υπάρχει επαρκής συνολική ελεύθερη μνήμη, αυτή δεν είναι διαθέσιμη σε ένα ενιαίο, συνεχόμενο μπλοκ. Όταν το FreeRTOS επιχειρήσει να εκκινήσει μια νέα λειτουργία, η δέσμευση θα αποτύχει, προκαλώντας την άμεση κατάρρευση του συστήματος (Hard Fault ή Kernel Panic).

Επιπρόσθετα, οι κλασικές συναρτήσεις `malloc` και `free` δεν είναι thread-safe. Αν δύο διεργασίες επιχειρήσουν να καλέσουν τη `malloc` ταυτόχρονα, η δομή ελέγχου του σωρού μπορεί να καταστραφεί. Ακόμη χειρότερα, ο χρόνος εκτέλεσής τους δεν είναι ντετερμινιστικός. Σε συστήματα πραγματικού χρόνου, η αδυναμία πρόβλεψης του χρόνου εκτέλεσης μιας συνάρτησης παραβιάζει θεμελιώδεις αρχές αξιοπιστίας.

Για την αντιμετώπιση αυτών των ζητημάτων, το FreeRTOS παρέχει τους δικούς του μηχανισμούς δυναμικής διαχείρισης (`pvPortMalloc()` και `vPortFree()`), προσφέροντας πέντε διαφορετικούς αλγορίθμους (από το `heap_1.c` που δεν επιτρέπει καθόλου απελευθέρωση μνήμης, έως το πολύπλοκο `heap_5.c` που ενώνει μη συνεχόμενες περιοχές μνήμης). Ωστόσο, η βιομηχανία προκρίνει μια πολύ πιο ασφαλή προσέγγιση: τη στατική δέσμευση μνήμης.

#### Η Βιομηχανική Λύση: Στατική Δέσμευση (Static Allocation)

Για τη βέλτιστη προετοιμασία ενόψει της ένταξης στην αγορά εργασίας, ο υποψήφιος μηχανικός πρέπει να αποδείξει ότι κατανοεί τις βέλτιστες πρακτικές ασφαλείας. Η στατική δέσμευση αποκλείει πλήρως τον μηχανισμό του σωρού (heap). Αντί η μνήμη να αναζητείται δυναμικά κατά τον χρόνο εκτέλεσης, ο ίδιος ο προγραμματιστής δεσμεύει στατικά τον απαραίτητο χώρο κατά τη φάση της μεταγλώττισης (compile time) υπό τη μορφή καθολικών μεταβλητών ή πινάκων.

| Χαρακτηριστικό Διαχείρισης | Δυναμική Δέσμευση (Dynamic Allocation) | Στατική Δέσμευση (Static Allocation) |
|---|---|---|
| Τρόπος Δημιουργίας | Αυτόματα από το λειτουργικό, μέσω `xTaskCreate` | Χειροκίνητα, μέσω `xTaskCreateStatic`, περνώντας διευθύνσεις μνήμης |
| Αξιοπιστία (Fragmentation) | Υψηλός κίνδυνος κατακερματισμού σε βάθος χρόνου | Μηδενικός κίνδυνος, η μνήμη παραμένει σταθερή και προκαθορισμένη |
| Έλεγχος RAM Footprint | Γίνεται εμφανής μόνο κατά τη διάρκεια εκτέλεσης | Υπολογίζεται με ακρίβεια από τον linker κατά τη μεταγλώττιση (build phase) |
| Περιβάλλον Χρήσης | Ιδανική για prototyping και συστήματα με επαρκή μνήμη | Υποχρεωτική σε αεροδιαστημικά, ιατρικά και κρίσιμα βιομηχανικά συστήματα |

Για την ενεργοποίηση αυτής της αρχιτεκτονικής στο έργο, ο χρήστης οφείλει να εντοπίσει το αρχείο ρυθμίσεων `FreeRTOSConfig.h` και να προσθέσει ή να τροποποιήσει τη γραμμή `#define configSUPPORT_STATIC_ALLOCATION 1`. Στη συνέχεια, οφείλει να υλοποιήσει τις συναρτήσεις υποστήριξης `vApplicationGetIdleTaskMemory()` και `vApplicationGetTimerTaskMemory()`, παρέχοντας τις μνήμες για τις διεργασίες συστήματος του RTOS, προτού αρχίσει να δημιουργεί τις δικές του διεργασίες ανάγνωσης αισθητήρων. Η γνώση αυτών των μηχανισμών καθιστά ένα βιογραφικό άμεσα ελκυστικό για εταιρείες που κατασκευάζουν κρίσιμο εξοπλισμό, όπου τα σφάλματα μνήμης απλώς δεν είναι αποδεκτά.

### Αρχιτεκτονική Μετάδοσης Δεδομένων: SPI και Ελεγκτής DMA

Μόλις τα δεδομένα των αισθητήρων ανακτηθούν επιτυχώς, ο μικροελεγκτής STM32 πρέπει να τα μεταδώσει στο Raspberry Pi Zero 2 W, το οποίο αναλαμβάνει χρέη κεντρικού συστήματος. Ενώ η θεωρητική γνώση του διαύλου UART είναι δεδομένη για κάθε φοιτητή, το SPI (Serial Peripheral Interface) προκρίνεται ως το βιομηχανικό στάνταρ για τη μεταφορά δεδομένων μεταξύ κυκλωμάτων στην ίδια πλακέτα λόγω της σύγχρονης (synchronous) φύσης του και των αισθητά υψηλότερων ταχυτήτων του.

Στο πλαίσιο του F411RE, οι ακροδέκτες που υποστηρίζουν το υποσύστημα SPI1 ταυτοποιούνται μέσω του φύλλου δεδομένων του επεξεργαστή:

| Σήμα SPI | Λειτουργία | Σύνδεση στο Nucleo-F411RE (SPI1) |
|---|---|---|
| NSS / CS | Επιλογή Συσκευής (Chip Select) | PA4 |
| SCK | Σήμα Χρονισμού (Serial Clock) | PA5 |
| MISO | Master In Slave Out (Δεδομένα προς Raspberry Pi) | PA6 |
| MOSI | Master Out Slave In (Δεδομένα από Raspberry Pi) | PA7 |

#### Το Ζήτημα της Απασχόλησης του Επεξεργαστή (CPU Bottleneck)

Σε μια παραδοσιακή υλοποίηση, για τη μετάδοση μιας συστοιχίας δεδομένων μέσω SPI, η κεντρική μονάδα επεξεργασίας γράφει ένα byte στον καταχωρητή δεδομένων (Data Register) του περιφερειακού SPI, ελέγχει διαρκώς έναν καταχωρητή κατάστασης (status register) περιμένοντας να αδειάσει το buffer (polling), και επαναλαμβάνει τη διαδικασία. Αυτή η προσέγγιση, γνωστή ως "blocking mode", είναι εξαιρετικά ανεπαρκής. Σε ταχύτητες της τάξης των Mbps, η CPU "παραλύει", σπαταλώντας χιλιάδες πολύτιμους κύκλους ρολογιού χωρίς να εκτελεί λειτουργικό κώδικα, παραβιάζοντας τον πυρήνα της αρχιτεκτονικής συστημάτων πραγματικού χρόνου.

#### Η Αξιοποίηση της Άμεσης Προσπέλασης Μνήμης (DMA)

Για την επίλυση αυτού του προβλήματος, το παρόν έργο επιβάλλει τη χρήση του ελεγκτή Άμεσης Προσπέλασης Μνήμης (DMA). Το DMA είναι ένας ανεξάρτητος ελεγκτής εντός του μικροελεγκτή που δρα ως "βοηθός" της CPU. Ο προγραμματιστής του δίνει τρεις παραμέτρους: τη διεύθυνση αφετηρίας (π.χ. τον πίνακα στη μνήμη RAM όπου το FreeRTOS αποθήκευσε τα δεδομένα των αισθητήρων), τη διεύθυνση προορισμού (τον καταχωρητή μεταφόρτωσης του SPI), και τον αριθμό των bytes που πρέπει να μεταφερθούν. Στη συνέχεια, ο ελεγκτής DMA αναλαμβάνει αυτόνομα τη μεταφορά, byte προς byte, αφήνοντας την CPU ελεύθερη να εκτελέσει άλλες διεργασίες.

Η ενεργοποίηση αυτού του μηχανισμού απαιτεί βαθιά γνώση του υλικού. Ο προγραμματιστής πρέπει να προσπελάσει τον καταχωρητή ελέγχου 2 (`SPI_CR2`) του περιφερειακού SPI και να ρυθμίσει τα αντίστοιχα bit για αιτήματα DMA. Συγκεκριμένα, η ρύθμιση της παραμέτρου `TXDMAEN` (Tx Buffer DMA Enable) δίνει εντολή στο SPI να ειδοποιεί το DMA κάθε φορά που είναι έτοιμο να δεχθεί νέα δεδομένα, ενώ η παράμετρος `RXDMAEN` εξυπηρετεί την αντίστοιχη διαδικασία λήψης.

| Λειτουργία DMA στον STM32 | Περιγραφή και Εφαρμογή στο Έργο | Κρίσιμα Ζητήματα (Pitfalls) |
|---|---|---|
| Normal Mode | Η μεταφορά εκτελείται μία φορά για το συγκεκριμένο μέγεθος πίνακα και έπειτα το DMA σταματά, αναμένοντας επανενεργοποίηση. | Ιδανικό για αποστολή μηνυμάτων (π.χ. JSON) συγκεκριμένου μεγέθους, αλλά απαιτεί διαρκές overhead από την CPU για την επαναλειτουργία του. |
| Circular Mode | Μόλις το DMA φτάσει στο τέλος του πίνακα, επιστρέφει αυτόματα στην αρχή και συνεχίζει τη μεταφορά, δημιουργώντας έναν κυκλικό χώρο μνήμης. | Συχνό πρόβλημα: αν το Raspberry Pi δεν προλάβει να διαβάσει τα δεδομένα, το DMA θα τα επανεγγράψει με μηδενικά ή νέα δεδομένα, προκαλώντας καταστροφή πληροφορίας (data wiping / race conditions). |

Η συνύπαρξη του FreeRTOS με το DMA δημιουργεί μια άριστη πρακτική: το υποσύστημα ετοιμάζει τα δεδομένα, ρυθμίζει το DMA και βυθίζει τη διεργασία (task) σε κατάσταση αναμονής (Blocked state). Όταν το DMA ολοκληρώσει τη μεταφορά ολόκληρου του πίνακα, δημιουργεί μια διακοπή (Interrupt). Η συνάρτηση εξυπηρέτησης της διακοπής (ISR) "ξυπνά" το task του FreeRTOS, το οποίο μπορεί πλέον να ετοιμάσει το επόμενο πακέτο δεδομένων. Η αρχιτεκτονική αυτή αποτελεί σήμα κατατεθέν των έμπειρων μηχανικών ενσωματωμένων συστημάτων.

---

## Υποσύστημα 2: Σταθμός Ανάλυσης, Σφαλμάτωσης και Παρατήρησης Υλικού (Hardware Debugging Station)

Στον παραδοσιακό προγραμματισμό (π.χ. σε γλώσσα Java, Python ή C++ σε υπολογιστές γραφείου), ο εντοπισμός σφαλμάτων επιλύεται με τη χρήση του τερματικού (console logs) ή ισχυρών εργαλείων αποσφαλμάτωσης (debuggers). Όταν, όμως, δύο ανεξάρτητες πλακέτες (το STM32 και το Raspberry Pi) επιχειρούν να επικοινωνήσουν μέσω ηλεκτρικών σημάτων (SPI, I2C) και η επικοινωνία αποτυγχάνει, το λογισμικό είναι ανίκανο να παρέχει ουσιαστικές πληροφορίες. Η αδυναμία διαγνωστικής παρατήρησης της φυσικής στιβάδας (physical layer) είναι ο συνηθέστερος λόγος που οι αρχάριοι μηχανικοί απογοητεύονται.

### Ο Αναλυτής Λογικής (Logic Analyzer) ως Εργαλείο Κριτικής Σημασίας

Με γνώμονα τη δήλωση του φοιτητή για περιορισμένο προϋπολογισμό των 50 ευρώ, η αγορά ενός επαγγελματικού παλμογράφου (που κοστίζει εκατοντάδες ή χιλιάδες ευρώ) καθίσταται αδύνατη. Ωστόσο, η βέλτιστη εναλλακτική είναι ένας Αναλυτής Λογικής που βασίζεται στον μικροελεγκτή Cypress FX2LP (CY7C68013A). Οι συσκευές αυτές διαθέτουν 8 κανάλια δειγματοληψίας και υποστηρίζουν ρυθμούς έως 24MHz.

Μια έρευνα στην εγχώρια αγορά και σε ηλεκτρονικά καταστήματα στην Ελλάδα (π.χ. Hellas Digital) ή την Ευρώπη (Elektor) δείχνει ότι ένας τέτοιος αναλυτής, πλήρης με καλώδια τύπου "hook clips", μπορεί να αποκτηθεί σε τιμές που κυμαίνονται από μόλις 8,50 ευρώ (για παραλλαγές με γυμνό PCB) έως 15 ή 30 ευρώ (για πλήρεις συσκευασίες). Η απόκτηση αυτού του εξοπλισμού μεταμορφώνει κυριολεκτικά τον τρόπο με τον οποίο προσεγγίζεται η μηχανική.

### Λογισμικό Sigrok και Θεωρητική Ανάλυση (PulseView)

Ο αναλυτής λογικής είναι ένα απλό κύκλωμα συλλογής δεδομένων. Η πραγματική δύναμη βρίσκεται στο λογισμικό που εκτελείται στον υπολογιστή ξενιστή. Εδώ υπεισέρχεται το ανοιχτού κώδικα έργο Sigrok, σε συνδυασμό με τη γραφική διεπαφή PulseView. Το PulseView λαμβάνει τις ακατέργαστες ψηφιακές ακμές από το υλικό και χρησιμοποιεί πάνω από 130 προγραμματισμένους αποκωδικοποιητές πρωτοκόλλων (protocol decoders) — γεγονός που επιτρέπει στον χρήστη να βλέπει απευθείας τα bytes που ταξιδεύουν μέσω του SPI, του I2C ή του UART.

#### Εφαρμογή του Θεωρήματος Nyquist-Shannon

Η χρήση του αναλυτή λογικής απαιτεί την κατανόηση θεμελιωδών νόμων της επεξεργασίας σημάτων, προεξάρχοντος του θεωρήματος δειγματοληψίας Nyquist-Shannon. Σύμφωνα με το θεώρημα, για την πιστή αναπαράσταση ενός σήματος, η συχνότητα δειγματοληψίας ($f_s$) πρέπει να είναι τουλάχιστον διπλάσια από τη μέγιστη συχνότητα του υπό παρατήρηση σήματος ($f_c$):

$$f_s \geq 2 \cdot f_c$$

Στην πράξη της ψηφιακής ανάλυσης, επειδή παρατηρούμε τετραγωνικά κύματα με απότομες ακμές (rising/falling edges) και όχι ημιτονοειδή σήματα, απαιτείται ρυθμός δειγματοληψίας τουλάχιστον τετραπλάσιος έως οκταπλάσιος της συχνότητας ρολογιού (clock frequency) του διαύλου. Εφόσον ο προτεινόμενος αναλυτής λογικής έχει μέγιστη συχνότητα $f_s = 24$ MHz, ο μηχανικός πρέπει να ρυθμίσει τη συχνότητα λειτουργίας του SPI (baud rate prescaler στον STM32) ώστε να μην υπερβαίνει τα 4 έως 6 MHz. Εάν το SPI εκπέμπει στα 10 MHz, ο αναλυτής των 24 MHz δεν θα προλαβαίνει να καταγράψει με ακρίβεια τις αλλαγές καταστάσεων, εμφανίζοντας παραμορφωμένα δεδομένα (aliasing effects). Η γνώση αυτών των φυσικών περιορισμών του υλικού είναι ενδεικτική ενός εξαιρετικά καταρτισμένου μηχανικού.

#### Μεθοδολογία Επίλυσης Προβλημάτων (Hardware Debugging)

Κατά την εκτέλεση του έργου, το PulseView θα χρησιμοποιηθεί για να επιλύσει τρία κρίσιμα ζητήματα που ταλανίζουν κάθε προσπάθεια επικοινωνίας:

- **Πολικότητα και Φάση Ρολογιού (CPOL & CPHA):** Στο πρωτόκολλο SPI, τα δύο συστήματα πρέπει να συμφωνούν ως προς το πότε δειγματοληπτούν τα δεδομένα. Αν ο STM32 διαβάζει τα δεδομένα στην κατερχόμενη ακμή του ρολογιού (falling edge) ενώ το Raspberry Pi τα εκπέμπει την ίδια ακριβώς στιγμή, τα δεδομένα θα καταστούν ανεξιχνίαστα (garbage data). Ο αναλυτής αποκαλύπτει ακριβώς τη χρονική στιγμή εναλλαγής και διευκολύνει τη διόρθωση των παραμέτρων στους καταχωρητές ελέγχου.
- **Προβλήματα Ακροδεκτών Pull-up (I2C):** Αντίθετα με το SPI (όπου οι γραμμές οδηγούνται άμεσα — push-pull), το I2C βασίζεται σε δομή ανοιχτού συλλέκτη (open-drain). Αν ο μηχανικός ξεχάσει να ενεργοποιήσει τις εσωτερικές pull-up αντιστάσεις του STM32 ή αν οι τιμές τους είναι λανθασμένες, το σήμα αδυνατεί να φτάσει στα 3.3V αρκετά γρήγορα. Το PulseView, μέσω αργών ανοδικών ακμών ή συνεχόμενων low καταστάσεων, αποκαλύπτει αμέσως τη φυσική απουσία των αντιστάσεων.

---

## Υποσύστημα 3: Η Πύλη Δικτύου και το Οικοσύστημα του Embedded Linux (Raspberry Pi Zero 2 W)

Το Raspberry Pi Zero 2 W είναι μια πλατφόρμα με κεντρική μονάδα επεξεργασίας 64-bit, προσφέροντας έναν ολοκληρωμένο μικροϋπολογιστή που υποστηρίζει ασύρματο δίκτυο (Wi-Fi) και διαθέτει 512MB RAM, σε εξαιρετικά συμπαγές μέγεθος και προσιτή τιμή (περίπου 15-20 ευρώ). Αυτό το καθιστά το απόλυτο όχημα για την πρακτική μετάβαση ενός φοιτητή από τον στενό χώρο των μικροελεγκτών στον απέραντο κόσμο του Ενσωματωμένου Linux.

### Διανομές Γενικού Σκοπού έναντι Εξειδικευμένων Συστημάτων Δόμησης

Οι περισσότεροι χομπίστες και αρχάριοι χρησιμοποιούν την επίσημη διανομή (Raspberry Pi OS/Raspbian), βασισμένη στο Debian. Αν και χρήσιμη, αυτή η προσέγγιση είναι ασύμβατη με τις αρχές της βιομηχανίας λογισμικού ενσωματωμένων συστημάτων. Στη βιομηχανία, οι εταιρείες ζητούν μηχανικούς που μπορούν να ελαχιστοποιήσουν το αποτύπωμα του λειτουργικού συστήματος, να ελέγξουν απόλυτα κάθε πακέτο λογισμικού, να εξαλείψουν άχρηστες διεργασίες υποβάθρου (background daemons), να μειώσουν τον χρόνο εκκίνησης στα ελάχιστα δυνατά δευτερόλεπτα, και να εγγυηθούν την ασφάλεια (security hardening). Για την επίτευξη αυτού του στόχου, η γνώση εργαλείων δημιουργίας προσαρμοσμένων λειτουργικών συστημάτων είναι η πολυτιμότερη δεξιότητα.

| Εργαλείο / Σύστημα | Φιλοσοφία και Μηχανισμός Λειτουργίας | Εκπαιδευτική και Επαγγελματική Αξία στο Έργο |
|---|---|---|
| Buildroot | Βασίζεται σε συστήματα Makefiles. Παράγει γρήγορα ένα τελικό rootfs, ένα kernel image, και ένα bootloader blob (monolithic build). | Εξαιρετικά απλό στην εκμάθηση. Ο χρήστης εκτελεί `make raspberrypi0_2w_defconfig` και αμέσως δημιουργεί ένα λειτουργικό σύστημα προσαρμοσμένο στο μέγεθος ελαχίστων Megabytes. Ιδανικό για πρώτη επαφή με το cross-compilation. |
| Yocto Project (Poky) | Βιομηχανικό πρότυπο, χρησιμοποιείται από κολοσσούς της βιομηχανίας. Βασίζεται στη μηχανή BitBake και σε μια αρχιτεκτονική στρωμάτων (layers) όπου αναμειγνύονται συνταγές (recipes) μεταγλώττισης. | Εξαιρετικά πολύπλοκο (steep learning curve), αλλά ζητείται με μανία στις συνεντεύξεις εργασίας. Διαχειρίζεται άδειες χρήσης και αυτόματες αναβαθμίσεις (OTA). |

### Σχεδιασμός και Παραγωγή Λειτουργικού Συστήματος (Yocto Project)

Για τις ανάγκες αυτού του έργου, συνιστάται η αξιοποίηση του Yocto Project. Η εμπειρία επίλυσης των σφαλμάτων του Yocto ισοδυναμεί με πολυετή πρακτική άσκηση σε βιομηχανικό περιβάλλον. Η διαδικασία περιλαμβάνει συγκεκριμένα, αυστηρά βήματα τα οποία ο φοιτητής θα εκτελέσει σε ένα τερματικό Linux του κεντρικού υπολογιστή του (Host PC):

1. **Λήψη της βάσης και των εξαρτήσεων:** Αρχικά γίνεται κλωνοποίηση της βασικής διανομής ελέγχου `poky` (π.χ. στην έκδοση `kirkstone` ή `scarthgap`), καθώς και του εξειδικευμένου επιπέδου υλικού `meta-raspberrypi`. Το στρώμα αυτό περιλαμβάνει όλους τους κανόνες για τη μεταγλώττιση του πυρήνα ώστε να είναι συμβατός με την αρχιτεκτονική του Broadcom SoC που φέρει το Raspberry Pi.
2. **Διαμόρφωση του συστήματος δόμησης:** Ο χρήστης αρχικοποιεί το περιβάλλον με την εντολή `source oe-init-build-env`. Στη συνέχεια, πρέπει να τροποποιήσει το αρχείο ρυθμίσεων `conf/bblayers.conf`, το οποίο λειτουργεί ως ευρετήριο των στρωμάτων (layers), ώστε ο μεταγλωττιστής να εντοπίσει τις συνταγές του Raspberry Pi.
3. **Παραμετροποίηση Μηχανήματος (Machine Configuration):** Στο αρχείο `conf/local.conf`, καθορίζονται τα τεχνικά χαρακτηριστικά της δόμησης. Εδώ, ο φοιτητής ορίζει ρητά `MACHINE??= "raspberrypi0-wifi"` για να στοχεύσει στο μοντέλο Zero 2 W. Σε αυτό το αρχείο, επιβάλλονται εξειδικευμένες επιλογές, όπως η ενεργοποίηση του σειριακού τερματικού (`ENABLE_UART = "1"`), του πρωτοκόλλου SPI (`ENABLE_SPI = "1"`) και η ένταξη πακέτων Wi-Fi (`linux-firmware-bcm43430 wpa-supplicant dhcpcd`) που είναι απολύτως απαραίτητα για την ασύρματη επικοινωνία.
4. **Η διαδικασία της Μεταγλώττισης (Cross-Compilation):** Με την εκτέλεση της εντολής `bitbake core-image-base`, ξεκινά η πλήρης δημιουργία του συστήματος. Κατά τη διάρκεια αυτής της φάσης, τα εργαλεία μεταγλώττισης (toolchains) χτίζουν από το μηδέν τον bootloader, τον Linux Kernel, και το root filesystem. Η διαδικασία είναι εξαιρετικά απαιτητική σε υπολογιστικούς πόρους.

Το τελικό αποτέλεσμα είναι μια συμπιεσμένη εικόνα δίσκου (`.wic.bz2` ή `.rpi-sdimg`) έτοιμη να εγγραφεί σε μια κάρτα SD μέσω εργαλείων όπως το `bmaptool` ή το `dd`, δημιουργώντας μια πλήρως λειτουργική και εξαιρετικά "ελαφριά" βάση εκκίνησης (bootable base system).

### Ανάπτυξη Οδηγών Πυρήνα (Linux Kernel Device Drivers)

Το κρίσιμο σημείο διαφοροποίησης ενός μηχανικού από έναν απλό χρήστη Linux είναι η ικανότητα πλοήγησης στον κώδικα του ίδιου του πυρήνα του λειτουργικού συστήματος. Ενώ τα δεδομένα του STM32 που καταφθάνουν στο Raspberry Pi μέσω του διαύλου SPI θα μπορούσαν να αναγνωστούν "πρόχειρα" μέσω διεπαφών χώρου χρήστη (user-space tools όπως το `spidev` και προγράμματα σε Python), αυτή η πρακτική υπολείπεται σε απόδοση, συγχρονισμό και εγγυήσεις διακοπών. Η επαγγελματική διαδρομή υπαγορεύει τη συγγραφή ενός αρθρώματος πυρήνα (Loadable Kernel Module - LKM) γραμμένο αποκλειστικά σε γλώσσα C.

#### Μηχανισμός Ανάπτυξης και Cross-Compilation

Η ανάπτυξη ενός οδηγού πυρήνα απαιτεί τον πηγαίο κώδικα του πυρήνα (kernel headers και kernel source) ώστε να εξασφαλιστεί η σωστή συνδεσιμότητα των βιβλιοθηκών της C με την υποκείμενη αρχιτεκτονική του λειτουργικού.

- **Ρύθμιση Toolchain:** Σε ένα ξεχωριστό περιβάλλον, γίνεται κλωνοποίηση του επίσημου αποθετηρίου (repository) του πυρήνα του Raspberry Pi. Απαιτείται η εγκατάσταση εργαλείων πολλαπλής μεταγλώττισης (cross-compilation), όπως το πακέτο `crossbuild-essential-arm64`, δεδομένου ότι ο κώδικας γράφεται σε x86/x64 υπολογιστή (Host) αλλά προορίζεται για τον Cortex-A53 (arm64 Target).
- **Παραμετροποίηση Πυρήνα:** Χρησιμοποιείται η προεπιλεγμένη ρύθμιση του πυρήνα `make ARCH=arm64 CROSS_COMPILE=aarch64-linux-gnu- bcm2711_defconfig` για την προετοιμασία των αρχείων ρυθμίσεων.

#### Η Δομή του Οδηγού (Device Driver Framework)

Το αρχείο C που θα αναπτύξει ο φοιτητής θα ενσωματώνει κρίσιμες βιβλιοθήκες, όπως την `<linux/spi/spi.h>` ή αντίστοιχα την `<linux/i2c.h>`. Στο κέντρο αυτού του αρχείου βρίσκεται η δημιουργία μιας δομής τύπου `spi_driver`.

Η φιλοσοφία του Linux βασίζεται στο μοντέλο Driver-Device match. Ο οδηγός δηλώνει την πρόθεσή του να διαχειριστεί μια συσκευή. Αυτό γίνεται μέσω δύο υποχρεωτικών συναρτήσεων:

- **Η συνάρτηση `probe()`:** Εκτελείται αυτόματα από το υποσύστημα του πυρήνα μόλις ανιχνευθεί συμβατό υλικό. Στο εσωτερικό της probe, ο μηχανικός εκχωρεί τη μνήμη, κατοχυρώνει (register) μια Συσκευή Χαρακτήρων (Character Device) και δημιουργεί τον απαραίτητο κόμβο (node) στον κατάλογο `/dev/` (π.χ., `/dev/stm32_sensor_node`), επιτρέποντας στα προγράμματα χώρου χρήστη να έχουν πρόσβαση.
- **Η συνάρτηση `remove()`:** Εκτελείται όταν η συσκευή αποσυνδεθεί (ή το άρθρωμα αφαιρεθεί μέσω της εντολής `rmmod`), αναλαμβάνοντας την απελευθέρωση όλων των πόρων για την αποφυγή διαρροών μνήμης (memory leaks).

#### Διαχείριση του Δέντρου Συσκευών (Device Tree Overlays)

Ένα συχνό ερώτημα κατά τη διάρκεια αυτών των έργων είναι: πώς γνωρίζει ο πυρήνας ότι η πλακέτα Nucleo του STM32 είναι συνδεδεμένη στις ακίδες SPI του Raspberry Pi; Τα πρωτόκολλα όπως το I2C και το SPI δεν διαθέτουν δυνατότητες άμεσου εντοπισμού ("plug-and-play" ή "hot-plug") όπως διαθέτει το USB.

Η απάντηση, η οποία αποτελεί κρίσιμη γνώση για κάθε Embedded Linux Engineer, βρίσκεται στο Δέντρο Συσκευών (Device Tree). Ο φοιτητής οφείλει να συντάξει ένα αρχείο περιγραφής υλικού (Device Tree Overlay με κατάληξη `.dts`), στο οποίο δηλώνει τον ακριβή ελεγκτή SPI του Broadcom SoC, καθορίζει τη διεύθυνση και το Chip Select της εξωτερικής συσκευής (STM32), και το κυριότερο, δηλώνει μια συμβολοσειρά συμβατότητας (π.χ., `compatible = "custom,stm32-sensor"`).

Όταν το λειτουργικό σύστημα εκκινεί, ο bootloader αναλύει το Device Tree και ενημερώνει τον πυρήνα για την ύπαρξη του υλικού. Ο πυρήνας, με τη σειρά του, αντιστοιχίζει τη συμβολοσειρά συμβατότητας με τη δήλωση του Loadable Kernel Module που δημιουργήσαμε παραπάνω, προκαλώντας την άμεση εκτέλεση της συνάρτησης `probe()`. Η επιτυχημένη ανάπτυξη, μεταγλώττιση, ανάλυση στο Device Tree και φόρτωση ενός αρθρώματος μέσω συστήματος αρχείων ext4/fat32 και αρχείων παραμετροποίησης, όπως το `config.txt` (`kernel=kernel-myconfig.img`), αποτελούν δεξιότητες που αποδεικνύουν ετοιμότητα επιπέδου Senior Engineer.

### Επίπεδο Εφαρμογής και Δικτύωσης (MQTT Broker)

Ο κύκλος ζωής της πληροφορίας ολοκληρώνεται με τη διάθεσή της στο τοπικό ή παγκόσμιο δίκτυο, μια απαίτηση ταυτόσημη με την ορολογία του Internet of Things. Για τον σκοπό αυτό, το έργο ολοκληρώνεται με την υλοποίηση ενός διακομιστή (broker) του πρωτοκόλλου MQTT. Το MQTT είναι το κυρίαρχο, ελαφρύ βιομηχανικό πρωτόκολλο επικοινωνίας μηχανής-προς-μηχανή (M2M) που βασίζεται στην αρχιτεκτονική τύπου δημοσίευσης-εγγραφής (publish-subscribe).

Χρησιμοποιώντας το σύστημα δόμησης (Yocto ή Buildroot), ο φοιτητής πρέπει να ενσωματώσει το πακέτο υποστήριξης Mosquitto. Για παράδειγμα, στο οικοσύστημα του Buildroot, αυτό επιτυγχάνεται μεταβάλλοντας την παράμετρο `BR2_PACKAGE_MOSQUITTO=y` στα αρχεία διαμόρφωσης `.config` ή `/defconfig`.

Η πρακτική λειτουργικότητα συνοψίζεται ως εξής: ένα απλό πρόγραμμα στον χώρο χρήστη (user-space application), γραμμένο σε C, θα εκτελεί έναν ατέρμονο βρόχο. Θα ανοίγει το αρχείο της Συσκευής Χαρακτήρων (π.χ., `open("/dev/stm32_sensor_node", O_RDONLY)`), θα ανακτά τα δεδομένα (όπως ακριβώς διαβάζουμε κείμενο από ένα αρχείο κειμένου) και, εάν εντοπίσει έγκυρες τιμές θερμοκρασίας και γυροσκοπίου, θα χρησιμοποιεί τις βιβλιοθήκες πελάτη του Mosquitto για να τα "δημοσιεύσει" (publish) σε δίκτυα όπως το τοπικό Wi-Fi. Οποιαδήποτε άλλη συσκευή στο δίκτυο (όπως το κινητό τηλέφωνο του φοιτητή ή ένας εξυπηρετητής βάσης δεδομένων SQLite μέσω παραμέτρων `BR2_PACKAGE_SQLITE`) μπορεί να λαμβάνει (subscribe) τα δεδομένα σε πραγματικό χρόνο.

---

## Οικονομικός Σχεδιασμός και Προϋπολογισμός Εξοπλισμού

Η παρούσα στρατηγική λαμβάνει απολύτως υπόψη τον περιορισμό του προϋπολογισμού στα 50 ευρώ, αξιοποιώντας την πλακέτα STM32 Nucleo-F411RE και το Raspberry Pi Zero 2 W που βρίσκονται ήδη στην κατοχή του φοιτητή. Με βάση μια αναλυτική εξέταση των τιμών του 2026 στην εγχώρια (Ελληνική) και διεθνή αγορά, παρατίθεται ο κατάλογος απαιτούμενου εξοπλισμού:

| Απαιτούμενος Εξοπλισμός / Εξαρτήματα | Λειτουργία στο Πλαίσιο της Αρχιτεκτονικής | Εκτιμώμενο Κόστος (€) |
|---|---|---|
| Αναλυτής Λογικής (Logic Analyzer) 24MHz - 8 Channel | Το πολυτιμότερο εργαλείο. Βασισμένο στο Cypress FX2LP chip. Απαιτείται για την ανάλυση και οπτικοποίηση σημάτων I2C, SPI και την εφαρμογή του PulseView/Sigrok (Debugging). | 8,50 € – 30,80 € (ενδεικτικά Hellas Digital, Elektor, Amazon) |
| Αισθητήρας BME280 ή BMP280 | Παρέχει τα ακατέργαστα δεδομένα θερμοκρασίας, υγρασίας, και βαρομετρικής πίεσης. Λειτουργεί ως περιφερειακός κόμβος I2C/SPI για τη λήψη περιβαλλοντικών συνθηκών (Edge sensing node). | 12,00 € – 15,00 € |
| Αισθητήρας MPU-6050 (Προαιρετικό) | Μονάδα Μέτρησης Αδράνειας (IMU) για μετρήσεις γυροσκοπίου και επιτάχυνσης μέσω I2C. Παρέχει εναλλακτική ροή δεδομένων για την ελαχιστοποίηση της μονοτονίας των δεδομένων θερμοκρασίας. | 3,00 € – 5,00 € |
| Καλώδια Διασύνδεσης (Jumper Wires) / Breadboard | Απαραίτητα για την ένωση των δύο πλακετών (STM32 και Raspberry) και την ανάπτυξη πειραματικών πρωτοτύπων. Καλώδια Male-to-Female και Female-to-Female είναι επιτακτικά. | 4,00 € – 7,00 € |
| **Συνολικό Εκτιμώμενο Κόστος** | Η συνολική επένδυση για την υλοποίηση ενός πλήρους εργαστηρίου υλικού και λογισμικού (Hardware/Software Dev Lab). | **~27,50 € – 57,80 €** |

Η απόκτηση ενός Αναλυτή Λογικής κρίνεται ως μια από τις πιο έξυπνες και στρατηγικές επενδύσεις που μπορεί να κάνει ένας επίδοξος Embedded Software Engineer. Με μια δαπάνη κάτω των 15-20 ευρώ, ο φοιτητής αποκτά δυνατότητες (όπως η αποσφαλμάτωση επιπέδου υλικού και η παρακολούθηση ασύγχρονων σημάτων) οι οποίες, πριν από μια δεκαετία, απαιτούσαν την αγορά εξοπλισμού και παλμογράφων βιομηχανικής κλίμακας, κόστους χιλιάδων ευρώ.

---

## Χρονοδιάγραμμα Υλοποίησης και Στρατηγική Ανάπτυξης Δεξιοτήτων

Δεδομένου ότι το έργο αυτό αντικαθιστά επί της ουσίας ένα πρόγραμμα καλοκαιρινής πρακτικής άσκησης (internship), ο διαθέσιμος χρόνος είναι άφθονος αλλά απαιτείται σωστή διαχείριση (project management). Προτείνεται μια μεθοδική, προοδευτική προσέγγιση σε κύκλους ανάπτυξης, οι οποίοι θα επιτρέπουν την ομαλή μετάβαση από το ένα γνωστικό αντικείμενο στο άλλο χωρίς την αίσθηση χαοτικής πολυπλοκότητας (cognitive overload).

| Φάση Ανάπτυξης | Κύρια Αντικείμενα Εστίασης | Αναμενόμενα Παραδοτέα (Deliverables) και Κατάκτηση Δεξιοτήτων |
|---|---|---|
| **Φάση 1: Hardware & RTOS** (Εβδομάδες 1-3) | Ανάγνωση datasheets, I2C bare-metal (BME280), ενσωμάτωση FreeRTOS, Στατική Δέσμευση Μνήμης. | Δημιουργία ενός συμπαγούς, αξιόπιστου Edge Node (STM32) χωρίς δυναμική μνήμη `malloc`, ικανού να επεξεργάζεται αισθητηριακά δεδομένα μέσω RTOS Tasks (Cortex-M Architecture). |
| **Φάση 2: DMA & Logic Analysis** (Εβδομάδες 4-5) | Ρύθμιση SPI με DMA. Χρήση του Αναλυτή Λογικής και του PulseView/Sigrok. | Μετάδοση μεγάλου όγκου δεδομένων χωρίς απασχόληση της CPU. Πρακτική εφαρμογή του θεωρήματος Nyquist-Shannon. Επίλυση χρονικών σφαλμάτων υλικού (Hardware debugging & optimization). |
| **Φάση 3: Embedded Linux & Yocto** (Εβδομάδες 6-8) | Χρήση Yocto Project ή Buildroot για το Raspberry Pi. Παραμετροποίηση αρχείων `local.conf`, `bblayers.conf` και `bitbake`. | Παραγωγή ενός εξειδικευμένου, ελαχιστοποιημένου συστήματος Linux. Κατανόηση των αρχιτεκτονικών στρωμάτων (recipes, layers, cross-compilation tools) (Linux Systems Engineering). |
| **Φάση 4: Kernel Modules & IoT** (Εβδομάδες 9-11) | Προγραμματισμός Device Drivers σε επίπεδο Πυρήνα. Device Tree Overlays (.dts). Ρύθμιση MQTT Broker (Mosquitto). | Ενοποίηση υλικού και λογισμικού (Hardware-Software Integration). Πρόσβαση στο υποσύστημα `spi_driver` του Linux. Εκπομπή μετρήσεων στο διαδίκτυο μέσω πρωτοκόλλων publish-subscribe (Kernel & IoT Protocols Development). |

---

## Επίλογος και Στρατηγική Αξιολόγηση Επαγγελματικού Προφίλ

Το τελικό παραδοτέο που θα προκύψει από αυτή την καλοκαιρινή ενασχόληση δεν θα είναι απλώς ένας "λειτουργικός κώδικας" τον οποίο ένας φοιτητής μπόρεσε να συναρμολογήσει χρησιμοποιώντας έτοιμες βιβλιοθήκες. Θα αποτελεί μια ολοκληρωμένη απόδειξη αρχής (Proof of Concept) μιας βιομηχανικής αρχιτεκτονικής συστήματος. Η φιλοσοφία του σχεδιασμού εστιάζει στην ενσωμάτωση πρακτικών — όπως η στατική διαχείριση μνήμης στο FreeRTOS, η χρήση DMA για την εξοικονόμηση πόρων της CPU, η κατασκευή προσαρμοσμένων λειτουργικών συστημάτων Linux μέσω Yocto, και η ανάπτυξη οδηγών (Device Drivers) στον ίδιο τον Πυρήνα του Linux.

Όταν ένας junior μηχανικός είναι σε θέση να τεκμηριώσει αυτές τις επιλογές σχεδιασμού κατά τη διάρκεια μιας συνέντευξης για εύρεση εργασίας, να παρουσιάσει την αναλυτική μεθοδολογία με την οποία προσέγγισε τη σφαλμάτωση ψηφιακών σημάτων με τη βοήθεια ενός Αναλυτή Λογικής και του λογισμικού PulseView, και να παραθέσει τον κώδικά του σε ένα καλά τεκμηριωμένο αποθετήριο (π.χ. στο GitHub), τοποθετεί αυτόματα το προφίλ του στο κορυφαίο ποσοστό των υποψηφίων. Η διασταύρωση των δεξιοτήτων χαμηλού επιπέδου (bare-metal) με τις δυνατότητες υψηλού επιπέδου του Linux (Linux architecture and modules) είναι, και θα παραμείνει καθ' όλη τη διάρκεια της δεκαετίας, η πλέον ισχυρή και περιζήτητη επαγγελματική εξειδίκευση στον ταχέως εξελισσόμενο τομέα της μηχανικής των Ενσωματωμένων Συστημάτων.
