Marios-Dimopoulos/stm32-freertos-iot-gateway/(commit log)

2026-09-27 Add empty Keil MDK-ARM project skeleton for STM32F411RE
2026-09-27 Vendor FreeRTOS-Kernel v11.3.1 (Cortex-M4F port) into firmware project
    Added core kernel sources (tasks.c, queue.c, list.c, timers.c, event_groups.c) and the RVDS/ARM_CM4F port layer as vendored source under firmware/stm32-sensor-node/FreeRTOS/. Chose vendoring over a git submodule for simplicity -- no submodule init step for anyone cloning this repo, and i want a pinned kernel version anyway.
    Deliberately excluded portable/MemMang/* (no heap -- static allocation only) and croutine.c//stream_buffer.c (unused legacy/optional features).
    Configured project include paths for FreeRTOS/include and FreeRTOS/portable/RVDS/ARM_CM4F. FreeRTOSConfig.h not yet written -- next step.
2026-09-28 I needed to delete the port.c and portmacro.h files, because the compiler that i use (Arm compiler 6) does not support the source code written in the portable\RVDS\ARM_CM4f\port.c. So it will fail to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
2026-09-29 Changed the port.c and portmacro.h files. The old ones came from the RVDS\ARM_CM4F. But due to compiler (armlang 6) not being compatible with the assembly written in these files, i needed to changes 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
2026-09-29 Edited the architecture.md file, so it has the current status of the project.
2026-09-30 Add FreeRTOSConfig.h tasks/stacks section
    128-word Idle stack (to be measured), timers and hooks off, stack
    overflow check method 2. configMAX_PRIORITIES left open until the
    task set is decided (see architecture.md).
2026-09-30 Add interrupt priority, assert and handler mapping config
    BASEPRI threshold at level 5 (raw 0x50), configASSERT halts with
    interrupts masked, and the port's SVC/PendSV/SysTick handlers are
    renamed to the startup file's vector names (direct routing).
2026-09-30 Set configMAX_PRIORITIES 3; switch docs to BMP280, drop IMU
    Task set: transmit (2), sensor (1), Idle (0). Debug logging goes over USART2 from the sensor task, so no logging task and no extra level.
2026-09-30 Add ADR-0004: interrupt priority threshold at level 5
    Records the two ISR groups and the reset-default-level-0 pitfall.
2026-10-01 Ignore firmware/**/reference/ (local-only course and teacher code)
    Reading material for writing our own drivers; not ours to redistribute.
2026-10-02 Add main.c: temporary PA5 blink task, first RTOS run on the board
    Blink observed by eye; period not measured yet (no logic analyzer). Docs updated.
2026-10-03 Add clock.c: CPU at 84 MHz from the HSI via the PLL; ADR-0006
    Flash wait states and the APB1 prescaler are set before the switch; bounded waits so a failed lock leaves the board on the HSI. Checked on the board by register values; true frequency not measured yet.
    [clock.c, clock.h, main.c]
2026-10-04 Add USART2 driver: pin, baud rate, first byte
    Own register-level driver; BRR computed from the real APB1 clock. Blocking send is temporary. Verified in Tera Term: two dots per second.
2026-10-04 USART2: interrupt-driven send through a ring buffer
    Tasks queue bytes inside a critical section; the TX interrupt (level 10, below the FreeRTOS line) drains them. Verified in Tera Term.
2026-10-05 USART2: whole-message writes with a drop counter
    A message that does not fit is dropped whole and counted, never cut. Verified with a burst of three 102-byte lines: two arrive, the third is dropped.
    [main.c, uart.c, uart.h]
2026-10-05 Add I2C1 driver step 1: clocks, reset, open-drain pins
    PB8/PB9 as AF4 open-drain with the internal pull-up as a backup; MODER is written last so the pins never drive the bus push-pull. Register values checked in the debugger.
    [i2c.c, i2c.h, main.c]
2026-10-06 I2C1: 100 kHz timing and i2c_probe; BMP280 answers ACK
    Timing computed from the real APB1 clock; the probe tells ACK from NACK with waits bounded by the RTOS tick. Verified on the board with the sensor at 0x76.
2026-10-06 I2C1: register write; remove the probe
    The write reports ACK/NACK itself, so the address-only probe was redundant. Verified: BMP280 soft-reset write returns OK.
    [i2c.c, i2c.h, main.c]
2026-10-06 I2C1: register read (1 byte and 3+ bytes)
    Receive deadline operations run in a short critical section; N=2 is refused. Verified on the BMP280: chip ID 0x58, 6-byte burst, 24 trimming bytes.
    [i2c.c, i2c.h, main.c]
2026-10-06 I2C1: error recovery and scheduler check; ADR-0007
    After a timeout or bus error the driver resets and re-initialises I2C1 itself. Verified with an SDA-to-ground test: TIMEOUT, then OK after release.
    [i2c.c, i2c.h, main.c]
2026-10-07 uart: explain why the write runs in a critical section
    Task-against-task and check+copy atomicity are the main reasons; the shared CR1 is kept as a third, judged benign.
2026-10-07 main: remove I2C bring-up tests, keep the chip-ID check
    Soft-reset, data-register and trimming tests are done; prvStatusText renamed prvStatusTextI2C.
    [main.c]
2026-10-07 main: remove the I2C debug helpers
    The chip-ID check and its status text are no longer needed; blink delays are now 1000 ms.
    [main.c]
2026-10-07 bmp280: soft reset and chip-ID check (step 1)
    Verified on the board: OK with CSB high, NACK with CSB low. A falling edge on CSB locks the sensor out of I2C until power-up; docs and ADR-0007 updated.
    [bmp280.c, bmp280.h, main.c]
2026-10-07 bmp280: configure and start the sensor (step 3)
    config (filter 16) then ctrl_meas (x16, normal mode), built from named fields; no read-back.
2026-10-07 bmp280: read and compensate (steps 4-6)
    Burst read, 20-bit raw values, integer temperature and pressure. Board: 23.64 C, 101969 Pa.
2026-10-07 format: tiny text formatter, no printf
    format_text, format_u32 and format_fixed2 write into a caller buffer, whole or nothing.
2026-10-08 sensor task: read the BMP280 once a second and print it
    Replaces the blink task and the LED code. Any error is counted and the sensor is initialised again next period. Stack measured: 89 words peak, 256 kept (ADR-0005).
    [main.c, sensor_task.c, sensor_task.h]
2026-10-08 uart: remove uart_write_string
    Its only caller now builds the line with the formatter and uses uart_write. Header comments trimmed.
2026-10-08 Trim work-in-progress notes from i2c.h, bmp280.h and clock.c
2026-10-08 docs: stack measurement, retest notes, architecture update
    ADR-0005: sensor task peak 89 words, 256 kept. ADR-0006: HSE_VALUE figure corrected (3.1x). ADR-0007: retest and CSB lock-out. architecture.md: sensor task, formatter, real status.
2026-10-08 Minor changes: I brought the architecture.md to the actual current state of the project.
2026-10-09 docs: add ADR-0008 and ADR-0009, update architecture.md
    ADR-0008: own register-level drivers (decided 2026-10-02, recorded now). ADR-0009: BMP280 module design. architecture.md brought in line with the code.
2026-10-09 uart: set PA2 output type, pull and speed explicitly
    Same values as the reset state, stated for intent like the I2C pins; MODER stays last.
    [uart.c]
2026-10-09 README: Phase 1 status, evidence, wiring, build and run
    Rewritten around what is verified and what is not; later phases are listed as roadmap, not claims. Adds the terminal screenshot.
2026-10-09 docs: architecture.md status, footprint and where to continue
    Phase 1 complete; footprint from the 2026-10-09 map; new section with the Phase 1 leftovers and the candidate first steps of Phase 2.
2026-10-09 README: shorten the unverified list
    Removes the I2C three-or-more-byte and the BMP280 datasheet items from the list (edit made in the working tree).
2026-10-11 ADR-0010: SPI link design (Pi master, fixed frame with CRC, mailbox, re-armed DMA)
2026-10-11 frame: 14-byte frame builder with CRC-16 (ADR-0010)
2026-10-11 frame: status codes get their own enum instead of a 0xFF sentinel
2026-10-11 sensor task: map bmp280_status_t to frame_status_t (not used yet)
2026-10-12 sensor task: build one frame per period into a latest-frame queue (checked on the board)
2026-10-12 ADR-0010: call the one-slot queue the latest frame, not a mailbox
2026-10-12 spi: SPI1 slave configuration, left disabled (ADR-0010)
2026-10-12 main: call spi_init() before the sensor task
2026-10-12 spi: DMA2 stream 3 feeds SPI1->DR, armed once, SPI enabled (ADR-0010)
2026-10-13 ADR-0010: why the DMA stream is stopped and checked before every reload
2026-10-13 spi: split the DMA setup into configure-once and reload-per-frame
2026-10-13 spi: comments now say what the board showed (CR and PAR kept, M0AR is a base address)
2026-10-13 spi: M0AR is a base address, written once with PAR
2026-10-13 spi: EXTI line 4 interrupt on NSS rising, counts ended transactions (ADR-0010)
2026-10-13 ADR-0010: EXTI on PA4 works in alternate-function mode (counter checked on the board)
2026-10-13 transmit task: woken by the NSS interrupt through a task notification (ADR-0010)
2026-10-13 ADR-0010: transmit task and the soak test (3000 transactions, no I2C errors)
2026-10-14 transmit task re-arms the DMA with the newest frame; the CPU primes DR with byte 0 (ADR-0010)
2026-10-16 spi: ignore a rising edge on NSS when NSS is low again, and count it (ADR-0010)
2026-10-16 uart: remove the drop counter (a drop cannot happen here, nothing read it); say who calls uart_write
2026-10-17 tools: spi_frame_test.py, reads and checks the frames on the Pi
2026-10-17 uart: assert that the scheduler has started in uart_write(), like the I2C driver
2026-10-17 docs: heap, uart assertion and HardFault handler recorded as verified; new footprint
2026-10-18 docs: stack peaks measured for sensor (96 words) and transmit (39 words), sizes kept
2026-10-18 docs: aborted-runs test recorded in ADR-0010 (no shifted or bad frame), stale NSS bullet fixed
2026-10-20 docs: first logic analyzer captures (I2C), clock measured about 1.1% fast
    Two Pico captures of the BMP280 read: address 0x76, register 0xF7, six bytes, ACK/NACK as designed. The 1 s task period (988-989 ms) and SCL (typical 101.1 kHz) agree on a clock about 1.1% fast. architecture.md and README also now say the image is built but never booted.
2026-10-20 docs: SPI logic analyzer captures: frame, clock at 1-6 MHz, back-to-back gap
    Seven captures plus the PulseView sessions and a README with wiring and settings. They show 112 clocks in mode 0, SCK 5.88 MHz at the 6 MHz setting, NSS high 154 us minimum between back-to-back reads, and the spikes that a disturbing probe wiring creates.
2026-10-20 firmware: comments brought up to date, no code change
    Progress markers and future-tense notes removed, hedges resolved against the BMP280 datasheet, measured results added (clock 1.1% fast, SCL, SCK, gap). Checked by comparing the code with comments stripped, before and after: identical in every file.
    [bmp280.c, bmp280.h, clock.c, frame.c, hardfault.c, i2c.c, main.c, sensor_task.c]
2026-10-21 docs: list ADR-0011 to 0014 in README, fix captures table, rename I2C captures
2026-10-23 Wi-Fi network baked into the image from a folder outside the repo, SPI on, secrets/ ignored
2026-10-24 spi-frame-test recipe and SPI on: 10 of 10 valid frames from the STM32 on the Yocto image; docs updated
2026-10-25 no tty1 getty (USE_VT=0); graphics switch-off tried and undone, cairo bbappend out of date; docs updated
2026-10-25 Phase 4 step 4.2: empty kernel module stm32_node built by a recipe, in the image, loads on the board
2026-10-27 wlan0: turn Wi-Fi power save off after ifup; suspected cause of unanswered ARP and dropped SSH, not yet built or tested on the board
2026-10-27 Phase 4 step 4.3: stm32_node becomes an SPI driver, device-tree overlay attaches it to chip select 0; probe runs at boot on the board. Open: mode 4 in probe, to be checked with a transfer in 4.4
2026-10-27 Switch off the vc4 overlay (VC4GRAPHICS=0 in rpi-config): CMA pool 256 to 64 MiB, 190 MB more RAM free on the board; DISABLE_VC4GRAPHICS avoided because it broke cairo
2026-10-29 Phase 4 step 4.4: probe does one SPI transfer and checks marker and CRC; 5 of 5 frames good on the board. mode 4 is the CS_HIGH flag the SPI core sets for a GPIO chip select. Each read returned the f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
2026-10-29 Docs: note the all-zeros dmesg at the first boot of the cleaned-up 4.4 image; cause not found, reload gave good frames
2026-10-29 Docs: correct the 4.4 note. The cleaned-up image showed the expected frames; the all-zeros remark was my misreading
2026-10-29 ADR-0018: kernel SPI driver with a raw-frame character device instead of spidev; the driver checks marker and CRC, the reading program decodes; probe tolerates a silent node. Records the measured sta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
2026-10-29 Phase 4 step 4.5a: probe registers a misc device; read() of /dev/stm32_sensor_node does one SPI transfer and returns the checked 14-byte frame, EIO for a bad frame, EINVAL for less than 14 bytes. Tes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
2026-10-29 Phase 4 step 4.5b: read() waits until 200 us have passed since the end of the previous transfer (mutex + usleep_range). 500 back-to-back reads and 8 concurrent readers all good; the 200 us on the wir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
2026-10-29 Phase 4 step 4.5c: read() does a throw-away transfer first and returns the second frame, so a read is fresh instead of the frame from the previous read. After 30 s idle the sequence moved by 30; afte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
    [stm32_node.c]
2026-10-31 Docs: bring architecture.md in line with the repo. Phase 4 driver done and MQTT paused, Pi no longer a test jig, stale read and gap now decided, SSH key-only, unverified Phase 4 items listed
2026-10-31 Docs: three Phase 4 items checked on the board. Chip select comes from cs-gpios in the Pi device tree (GPIO 8, active low), a 14-byte transfer uses the controller interrupt (10 for 10), rmmod refuses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
2026-10-31 ADR-0020 and ADR-0021: MQTT broker on the Pi with a C publisher using libmosquitto; one JSON message per frame on gateway/stm32/bmp280, publish when seq changes, status errors published without numbe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
2026-10-31 Step 4.6b: Mosquitto broker in gateway-image. A bbappend builds it without ssl and websockets and installs a config that listens on 127.0.0.1 only. On the board it runs as the mosquitto user and list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
2026-10-31 Docs for 4.6a and 4.6b. OpenSSL was already in the image through wpa_supplicant and sshd, so removing ssl from the broker saved no package; ADR-0020 corrected. Wi-Fi power-save line now applied on th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
2026-10-31 Step 4.6c piece 1: gateway-publisher reads one frame from /dev/stm32_sensor_node and prints it decoded, integers only. The driver already checks marker and CRC, so the program does not. On the board: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
2026-10-31 Step 4.6c piece 2: gateway-publisher builds the ADR-0021 message as JSON from integers only. A status other than 0 leaves the numbers out so a failed reading never shows as 0.00 C; a message that doe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
2026-10-31 Step 4.6c piece 3: gateway-publisher connects to the broker on localhost and publishes the JSON to gateway/stm32/bmp280 with QoS 0, no retain, client ID gateway-publisher. First full run on the board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
2026-10-31 Step 4.6c piece 4: gateway-publisher loops. Reads every 200 ms and publishes when the sequence changes; read and publish failures are logged once when they start and once when they end; SIGINT/SIGTER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
2026-11-01 Step 4.6c piece 5: gateway-publisher starts at boot. Init script S40 (after the broker S30) and K20, installed with update-rc.d. At start the program waits for the device file and the broker instead 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
2026-11-01 Docs for step 4.6c. New ADR-0022: init script, retry in the program and syslog, with what is not tested (shutdown order, a crash is not restarted). ADR-0020 and ADR-0021 still said nothing was built;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
2026-11-02 Checked on the board how the driver is found and loaded, and recorded it. spi0.0 has modalias spi:stm32-sensor-node, modules.alias maps it to stm32_node, and after rmmod, writing add to the uevent fi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
    Also gateway-image.bb: the root.hash path is now ${TOPDIR}/../secrets/root.hash instead of one with my user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
2026-11-02 Step 4.7: docs for the finished project. The README stopped early in Phase 4; it is now a portfolio page for all four phases: the whole data path, the evidence for each part, the 22 ADRs, how to buil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
    architecture.md: status brought up to date, the board checks of how the driver is loaded and the boot scripts read in the build folder are recorded, and the meta-yocto commit typo is fixed. ADR-0018: the interrupt rat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
2026-11-03 Wi-Fi secrets folder found at ${TOPDIR}/../secrets, like root.hash, so no file in the layer has my user name and the layer builds for any user with secrets/ next to the build folder. Copied the three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
2026-11-04 Kill test of the publisher done on the board, and screenshots added to the README. kill -TERM ended the publisher and kill -9 ended it too; 10 seconds later nothing had restarted it, so ADR-0022's "n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
2026-11-04 Hardware photos added to the README: a new photo of the setup (setup.jpg, replacing setup.png, which is deleted; the old file stays in git history), the Raspberry Pi Pico used as the logic analyzer, 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
2026-11-05 meta-gateway had the unedited README that bitbake-layers create-layer writes: "<first dependency>", a fake mailing list, a fake maintainer and "replace with specific information". It is now a short R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
2026-11-08 Reorganized docs/architecture.md, which had grown to 1425 lines with the same facts in several places: what is not verified was listed in five sections (the 200 us gap 13 times, the NSS spikes 14 tim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
2026-11-08 Shorter comments in the meta-gateway recipes. The step-by-step history (which step added what, which build failed) was mixed with the code and made the recipes hard to read. In gateway-image.bb the r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
    [stm32_node.c]
2026-11-08 Modifications on a comment on the stm32-node_1.0.bb file and on the linux-gateway/README.md file
